jms1005/knock2fa/버튼시퀀스_노크리듬_2FA_계획서.docx

2026 COSS 차세대반도체 MCU 응용 경진대회

출품 계획서 (초안)

버튼 시퀀스 · 노크 리듬 기반 저비용 이중 인증(2FA) 잠금 시스템

※ 본 문서는 대화 내용을 바탕으로 초안을 잡은 것입니다. 대회 요강이 지정하는 정식 항목 번호·양식이 있다면 그에 맞춰 절 번호를 다시 매겨야 합니다 — 원본 공모전 안내문(공모전자료 폴더)과 대조해 주세요.

# 1. 개요

## 1.1 제안 배경

저비용 임베디드 잠금장치는 대부분 버튼 PIN 입력 한 가지에만 의존한다. PIN은 옆에서 지켜보는 것만으로 그대로 노출되는 '지식 기반 단일 인증'이라는 구조적 한계가 있다. 반면 지문·얼굴 인식 등 생체 인증 모듈은 정확하지만 원가와 처리 부담이 커서, 8비트 MCU 한 개·핀 몇 개로 승부하는 이번 대회의 채점 기준(부품 원가, 사용 핀 수, 코드/데이터 메모리 크기)과는 맞지 않는다.

본 프로젝트는 여기서 나노/재료공학 전공자의 관점이 아니라, 저비용 센서 하나를 추가해 '지식'과 '행동'이라는 서로 다른 성격의 증거 두 가지를 요구하는 인증 구조를 저비용·저전력 MCU 위에서 구현하는 데 초점을 둔다.

## 1.2 제안 내용 요약

등록된 버튼 4개를 정해진 순서로 누르는 지식 기반 1단계와, 표면을 두드리는 리듬(간격 패턴)을 압전(피에조) 소자로 측정해 등록된 사용자의 패턴과 비교하는 행동 기반 2단계를 결합한다. 두 단계는 서로 다른 물리 채널(디지털 GPIO / 아날로그 ADC)에서 독립적으로 검증되며, 둘 다 통과해야 잠금이 해제된다.

## 1.3 목표

- 추가 부품 하나(피에조 소자)만으로 지문 인식 수준의 '두 번째 인증 계층'을 저비용으로 구현한다.
- Arduino IDE·외부 라이브러리 없이 ADC·타이머·EEPROM·I²C를 전부 레지스터 직접 제어로 구현한다.
- 동일한 사람이 순서를 알고 있어도 리듬까지 재현하지 못하면 인증에 실패한다는 것을 실측으로 증명한다.

# 2. 문제의식 및 차별점

## 2.1 기존 저비용 잠금장치의 한계

- 버튼 PIN 키패드: 입력 순간을 옆에서 보거나, 자주 누르는 버튼의 마모 흔적만으로도 순서가 유추될 수 있다.
- RFID 카드: 카드 자체를 분실·복제당하면 그대로 무력화된다.
- 지문/얼굴 인식 모듈: 정확하지만 모듈 원가가 최종 시스템 원가를 크게 높이고, 8비트 MCU로는 영상 처리 자체가 어렵다.

## 2.2 본 설계의 접근

정답 '순서'를 안다고 해도, 그 순서를 두드리는 '리듬'까지 똑같이 재현하기는 어렵다는 점에 착안했다. 이는 키보드 타이핑 습관으로 사용자를 구분하는 키스트로크 다이내믹스(keystroke dynamics) 연구와 같은 원리이며, 여기서는 이를 초저가 압전 소자 하나로 구현한다. 두 계층이 서로 다른 센서·회로에서 독립적으로 얻어진다는 점이 핵심이며, 이 덕분에 한쪽 정보가 유출되어도 나머지 한쪽까지 뚫기는 어렵다.

# 3. 동작 원리

## 3.1 인증 구조 — 2단계

- 1단계 (지식): 등록된 버튼 4개 중 정해진 순서로 입력. button.c의 디바운스 로직으로 각 입력을 이벤트화.
- 2단계 (행동): 표면을 두드리는 리듬(노크 간 시간 간격)을 피에조로 측정, 등록된 사용자 패턴과 비교.

두 단계는 순차적으로 진행되며, 1단계를 통과한 경우에만 2단계로 넘어간다. 둘 다 통과해야 최종 '잠금 해제' 신호를 출력한다.

## 3.2 피에조 노크 감지 원리

압전(피에조) 디스크는 기계적 충격을 받으면 압전 효과로 순간적인 전압을 발생시킨다. 이 전압을 저항 분배·클램프 회로를 거쳐 MCU의 ADC 입력으로 샘플링하고, 정해진 임계값을 넘는 순간을 '노크 이벤트'로 판정한다. 두 노크 사이의 시간 간격을 타이머로 측정해 [t1, t2, t3, …] 형태의 시간 벡터를 만든다.

이 방식은 기존 LED PEDD 프로젝트에서 '시간을 재서 벡터로 만들고 분류기에 넣는다'는 접근을 그대로 계승한다. 다만 광량 대신 압전 신호를 트리거로 쓴다는 점이 다르며, 발광-검출 정렬이나 차광 같은 광학적 제약이 전혀 없다는 것이 실무적으로 가장 큰 차이다.

## 3.3 시간 벡터화 및 분류 알고리즘

측정된 간격 벡터는 기존 classify.c의 정수 연산 최근접 중심점(nearest-centroid) 분류기에 그대로 입력된다. 부동소수점을 쓰지 않고 유클리드 거리 제곱의 대소 비교만으로 판정하므로 8비트 MCU에서도 가볍게 동작한다.

## 3.4 학습(등록) 및 인증 흐름

- 학습 모드: 사용자가 같은 순서·리듬을 3~5회 반복 입력 → 평균 벡터(중심점)를 산출해 EEPROM에 저장 (store.c 재사용).
- 인증 모드: 새로 입력된 순서가 일치하는지 먼저 확인 → 일치하면 리듬 벡터와 저장된 중심점 사이의 거리를 계산 → 임계값 이내면 인증 성공, OLED에 결과 표시.

# 4. 시스템 구성

## 4.1 블록도 (텍스트 설명)

버튼 4개 → MCU 디지털 입력(내부 풀업) / 피에조 → 보호저항·전압분배 → MCU 아날로그 입력(ADC) / MCU → OLED(상태 표시) + UART(로그) / 인증 성공 시 MCU → 액추에이터 핀(데모용 LED 또는 서보모터로 '열림' 표시).

## 4.2 MCU 핀 사용 계획

핀 | 연결 대상 | 방향 | 비고
D2 ~ D5 | 버튼 4개 | 입력 (내부 풀업) | 정해진 순서로 입력받는 지식 인증부
A0 (ADC0) | 피에조 소자 | 아날로그 입력 | 노크 충격 전압 샘플링
A4 / A5 | OLED SDA / SCL | I²C | 기존 i2c.c · ssd1306.c 재사용
D8 | 액추에이터 / 상태 LED | 출력 | 인증 성공 시 '열림' 신호
— (USB) | UART 로그 | 직렬 | 보드의 USB 단자가 담당

총 사용 핀 7~8개 수준으로, 대회 채점 기준(사용 핀 수)에서 여유가 있다.

## 4.3 소프트웨어 구성 — 재사용 모듈

모듈 | 기존 LED 프로젝트에서의 역할 | 이번 프로젝트에서의 역할
button.c | Phase 4 버튼 디바운스 | 버튼 시퀀스 입력 이벤트화 (그대로 재사용)
classify.c | R/G/B 방전시간 벡터 최근접 중심점 분류 | 노크 간격 벡터 최근접 중심점 분류 (그대로 재사용)
store.c | EEPROM에 학습된 중심점 저장 | 사용자별 등록 패턴 저장 (그대로 재사용)
i2c.c / ssd1306.c | OLED에 판정 결과 출력 | 인증 상태·안내 문구 출력 (그대로 재사용)
uart.c | 측정값 CSV 로깅 | 인증 시도 로그, 실험 데이터 수집 (그대로 재사용)
pedd.c 아키텍처 | Analog Comparator + Timer1 캡처로 방전시간 측정 | 신규 adc_knock.c로 대체 — ADC + 타이머로 노크 간격 측정

# 5. 대회 제약사항 준수

- MCU: ATmega328P (16MHz), Arduino Uno 호환보드 사용 — 요강상 사용 가능 MCU.
- Arduino IDE 및 외부 라이브러리 미사용 — 개발 환경은 Microchip Studio, 전 구간 레지스터 직접 제어.
- 부동소수점 미사용 — 전 구간 32비트 정수 연산 (classify.c 기존 구현 그대로 계승).

# 6. 부품 목록 및 원가

## 6.1 기존 보유 부품 (그대로 재사용)

품목 | 사양 | 수량 | 비고
Arduino Uno 호환보드 | ATmega328P 탑재 | 2 (본체+예비) | LED 프로젝트에서 이미 확보
택트 스위치 | 4핀 | 5 | 시퀀스 입력용
I²C OLED | 0.96" SSD1306 | 1 | 상태 표시
저항 | 220 / 330 / 470 / 1kΩ | 각 10 | 회로 보조용
브레드보드 · 점퍼선 | 830핀 + M/M, M/F | 1식

## 6.2 신규 구매 필요

품목 | 사양 | 수량 | 예상 단가 | 비고
피에조 진동/노크 센서 | 압전 디스크 | 2 | 약 500~1,500원 | 노크 리듬 측정 핵심 부품
저항 | 1MΩ | 2 | 약 100원 | ADC 핀 보호용 블리드 저항

신규 구매 총액은 약 2,000~3,500원 수준으로, LED 프로젝트 대비 부품 리스크와 배송 대기 부담이 크게 줄어든다.

# 7. 실험 및 검증 계획

단계 | 목적 | 방법 | 판정 기준
① 피에조 특성 측정 | 노크 세기별 ADC 응답 확인 | 약하게/세게 두드리며 ADC 값 기록 | 노크 유무를 구분하는 임계값 결정
② 버튼 시퀀스 단독 검증 | 1단계 동작 확인 | 정답/오답 순서 각각 입력 | 정답만 통과, 오답은 전부 거부
③ 리듬 재현성 측정 | 동일 사용자 반복 시 변동성 확인 | 같은 사용자가 10회 이상 반복 입력 | 변동계수(CV)가 임계값 설계 범위 이내
④ 타인 모사 시도 | 2FA 효과 실증 (핵심 실험) | 순서를 알려준 제3자가 흉내내어 시도 | 순서를 알아도 리듬 불일치로 거부되는 비율 측정
⑤ 실패 대응 확인 | 오인식 시 동작 확인 | 임계값 경계 부근에서 반복 시도 | 재시도 제한, 안내 문구 정상 표시

# 8. 개발 일정 (9/9 ~ 9/18)

기간 | 작업
9/9 ~ 9/10 | 계획서 확정, 피에조·저항 주문, 회로도·핀 배정 확정
9/10 ~ 9/12 | 부품 도착, adc_knock.c 작성 및 버튼·피에조 단독 동작 검증
9/12 ~ 9/14 | classify.c·store.c 연동, 학습/인증 흐름 통합 및 1차 테스트
9/14 ~ 9/16 | 실험 ①~⑤ 진행, 데이터 수집 및 임계값 튜닝
9/16 ~ 9/18 | 계획서·회로도·발표자료(PPT) 최종화, 시연 영상 촬영, 제출

# 9. 기대효과 및 차별성

- 추가 원가 약 2,000~3,500원 수준으로 지식+행동 이중 인증을 구현 — 지문 모듈 대비 압도적으로 저렴.
- Arduino 라이브러리 없이 ADC·타이머·EEPROM·I²C를 전부 레지스터로 직접 구현 — 대회가 요구하는 순수 구현력에 부합.
- 기존 LED PEDD 프로젝트에서 검증된 '시간 벡터 → 정수 분류기' 아키텍처를 재사용해 개발 리스크와 일정 리스크를 최소화.
- 타인 모사 시도 실험으로 2FA 효과를 정량적으로 증명 — 단순 아이디어 제시에 그치지 않고 실측 데이터로 뒷받침.

# 10. 한계점 및 향후 계획

- 피에조 신호는 부착 방식·표면 재질에 따라 민감도가 달라질 수 있다 — 향후 다중 피에조 또는 디지털 필터링으로 개선 가능.
- 리듬 재현성은 개인 컨디션에 따라 변동할 수 있다 — 등록 시 다회 샘플링과 임계값 여유 설계로 대응.
- 현재 EEPROM 용량 한계상 등록 가능한 사용자 수가 제한적이다 — 다중 사용자 지원은 향후 과제로 남긴다.

# 11. 참고

본 계획서는 2026 COSS 차세대반도체 MCU 응용 경진대회 출품을 위해 기존 'LED 다파장 재이용 광검출 기반 저비용 액체 광학 분석기' 프로젝트에서 확보한 소프트웨어 아키텍처(정수 연산 분류기, EEPROM 저장, OLED·UART 출력)를 재사용하여 작성되었다.
