jms1005/knock2fa/최종 보고서.pdf

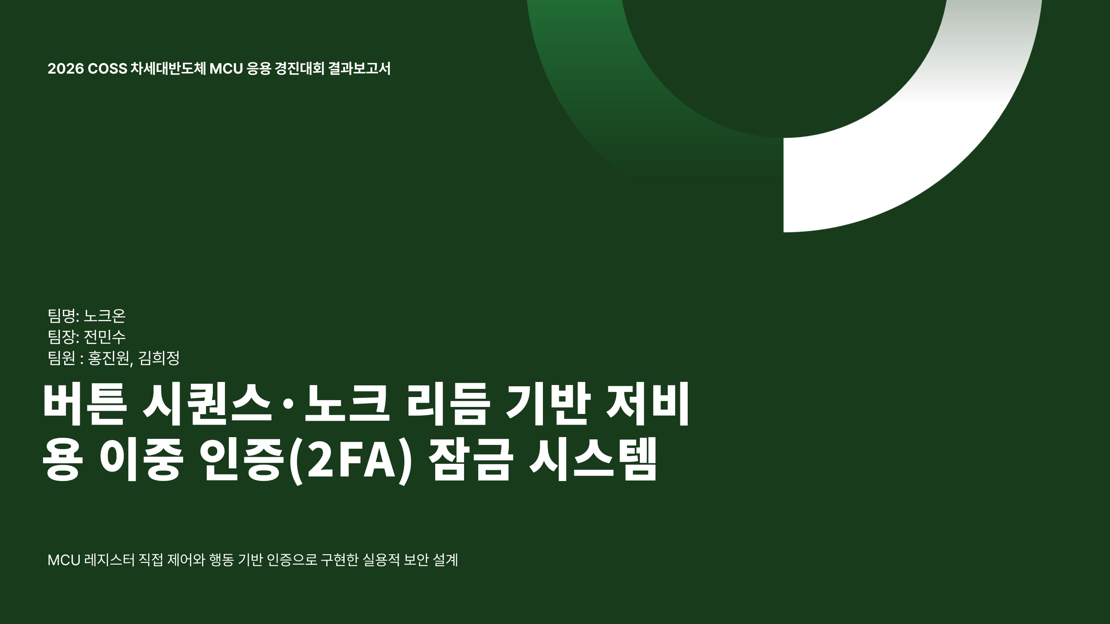
[picture p1: page 1]

MCU 레레레레 | 레레 레레레 | 레레 레레 레레레레 | 레레레 | 레레레 | 레레 레레
레레 레레레 | · 레레 레레 레레 레레

# 레 레레 레레 (2FA) 레레 레레레

2026 COSS | 레레레레레레 | MCU 레레 레레레레 | 레레레레레

레레 : 레레레
레레 : 레레레
레레 : 레레레 , 레레레

레레 레레레 | 레레레레레 | 레레

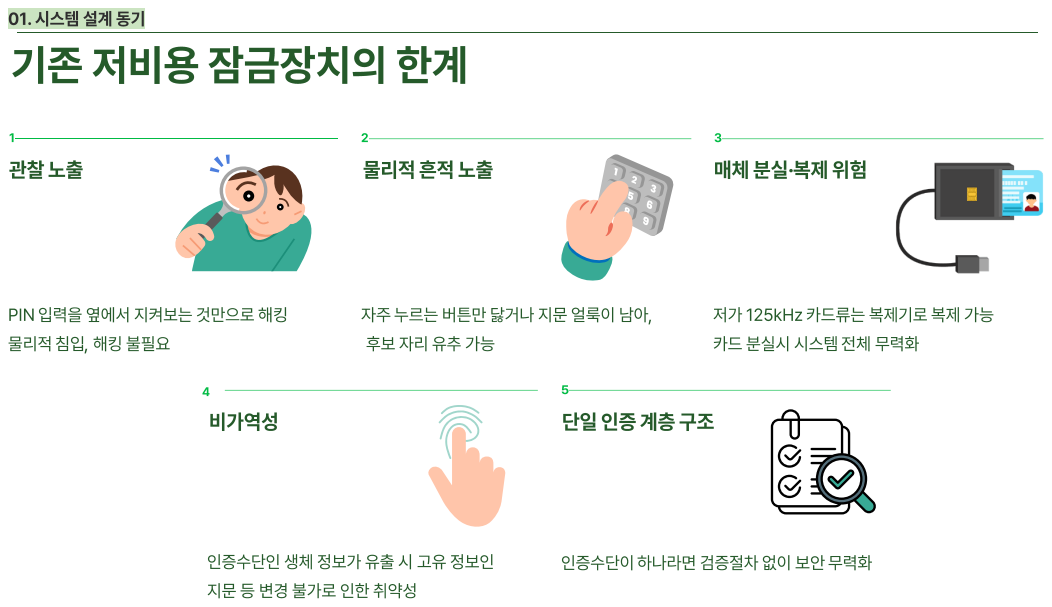
[picture p2: page 2]
PIN 레레레; 레레레; 레레레레; 레레 , 레레 레레레; 레레 레레레; 레레 125kHz 레레레레; 레레레레레; 레레 레 레레 레레레; 레레 레레 레레레

Keystroke Dynamics | 레레 레레레 | 레레 레레 레레

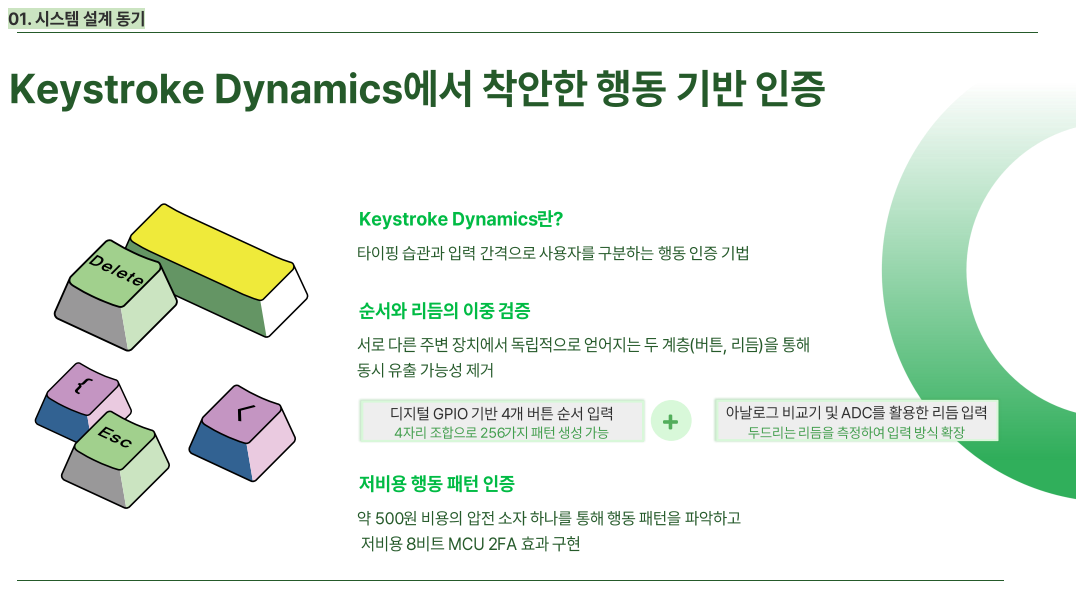
[picture p3: page 3]
레레레; 레레 레레레레; 레레레레; Keystroke Dynamics; 레레 레레 레레 레레레레; 레레레레레; 레레 레레 레레레; 레 500 레 레레레; 8레레 MCU 2FA 레레 레레; 레 ADC 레 레레레; GPIO 레레 4레 레레 레레 레레; 4레레 레레레레

# 레레레레

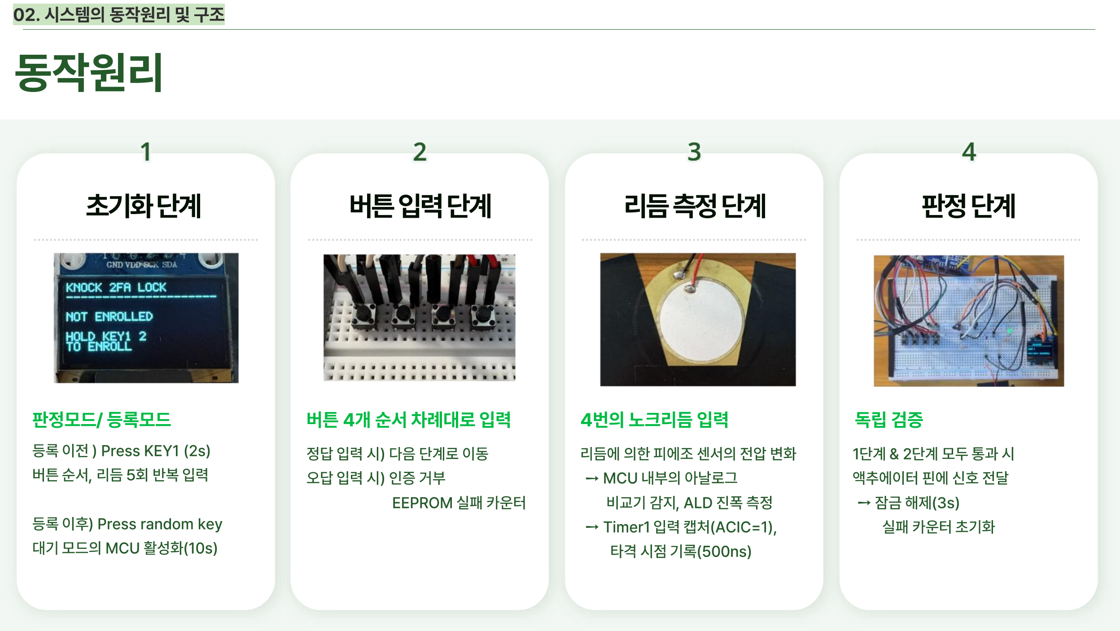
[picture p4: page 4]

레레 레레 ) Press KEY1 (2s)
레레 레레 , 레레 5레 레레 레레

레레 레레 ) Press random key
레레 레레레 | MCU 레레레 (10s)
레레레레 | / 레레레레
레레 레레 레 ) 레레 레레레 | 레레
레레 레레 레 ) 레레 레레
EEPROM 레레 레레레
레레 4 레 레레 레레레레 | 레레
레레레 | 레레 레레레 | 레레레 | 레레 레레
➙ MCU 레레레 | 레레레레
레레레 | 레레 , ALD 레레 레레
➙ Timer1 레레 레레 (ACIC=1),
레레 레레 레레 (500ns)

### 4 레레 레레레레 레레

1레레 & 2레레 레레 레레 레
레레레레레 레레 레레 레레
➙ 레레 레레 (3s)
레레 레레레 레레레

### 레레 레레

레레레 레레 | 레레 레레 레레 | 레레 레레 레레 | 레레 레레
02. | 레레레레 | 레레레레 | 레 | 레레

# 레레 레레레레 - 2레레 & 3레레

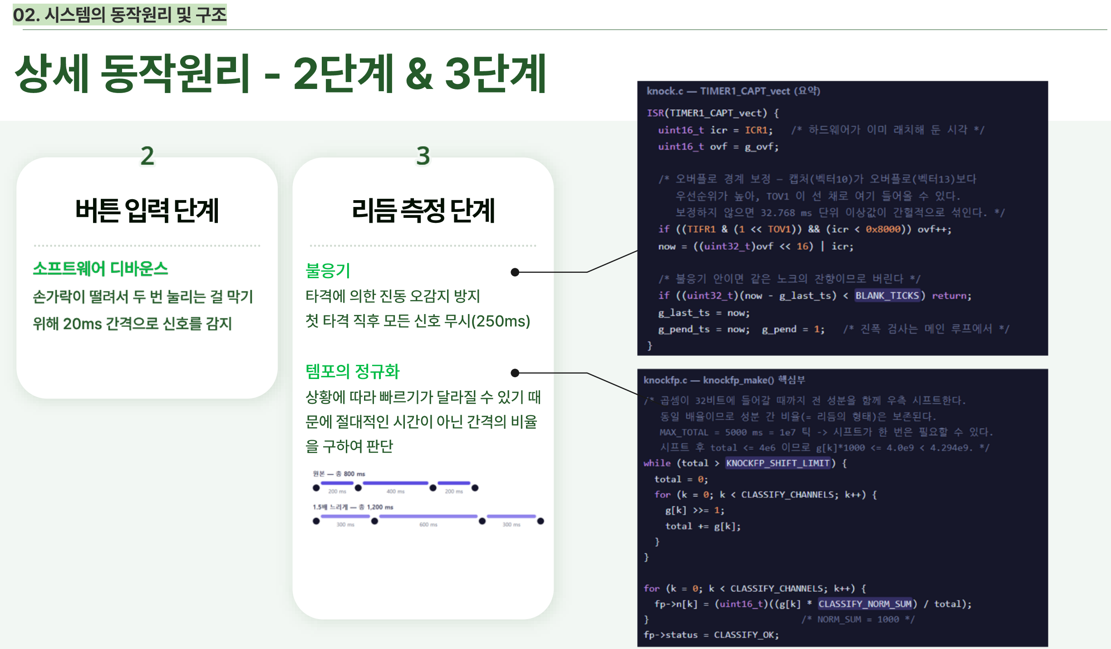
[picture p5: page 5]

불불불
레레레 | 레레 레레 레레레 | 레레
레 레레 레레 레레 레레 레레 (250ms)
불불불 | 불불불
레레레 | 레레 레레레레 | 레레레 | 레 레레 레
레레 레레레레 | 레레레 | 레레 레레레 | 레레
레 레레레 | 레레
레레 레레 레레 | 레레 레레 레레
02. | 레레레레 | 레레레레 | 레 | 레레

# 레레 레레레레 - 4 레레

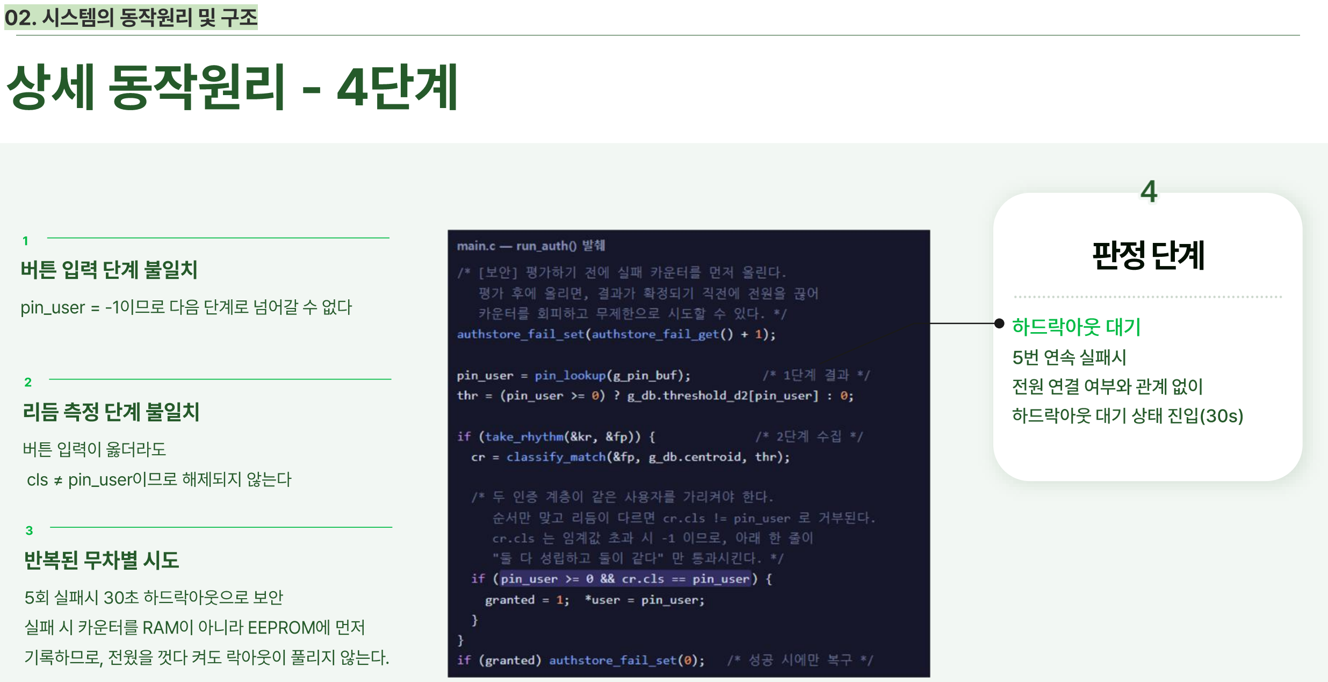
[picture p6: page 6]

불불불불불 불불
5레 레레 레레레
레레 레레 레레레 | 레레 레레
레레레레레 | 레레 레레 레레 (30s)

# 레레 레레

pin_user = - 1레레레 | 레레 레레레 | 레레레 | 레 레레

1
레레 레레 레레 레레레
레레 레레레 | 레레레레
cls ≠ pin_user 레레레 | 레레레레 | 레레레

2
레레 레레 레레 레레레
5레 레레레 | 30 레 레레레레레레레 | 레레
레레 레 레레레레 | RAM레 레레레 | EEPROM 레 레레
레레레레레 | , 레레레 | 레레 레레 레레레레 | 레레레 | 레레레 .

3
레레레 | 레레레 | 레레
02. | 레레레레 | 레레레레 | 레 | 레레

# 레레레 레레레

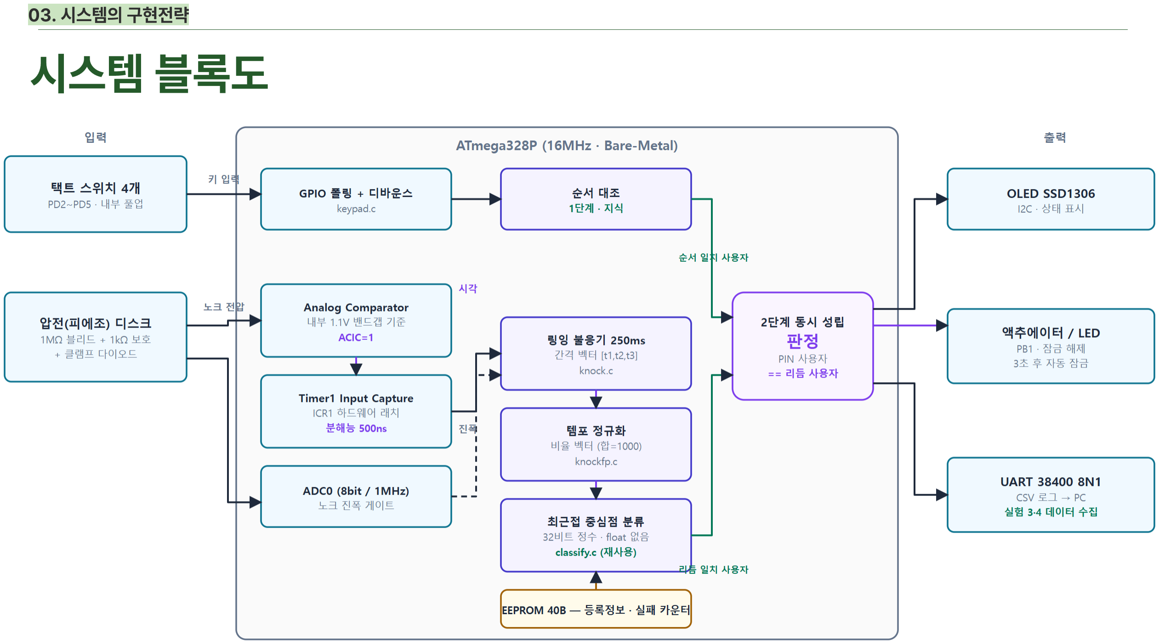
[picture p7: page 7]

03. | 레레레레 | 레레레레

# 레레레레 레레

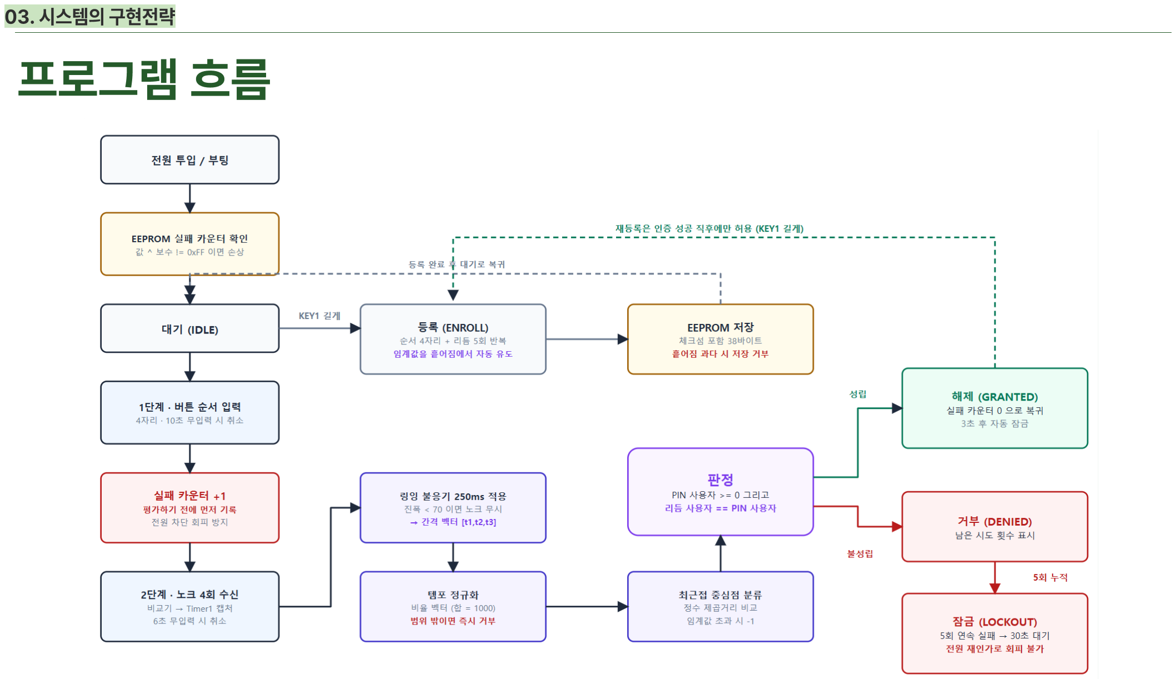
[picture p8: page 8]

03. | 레레레레 | 레레레레

# 레레 레레

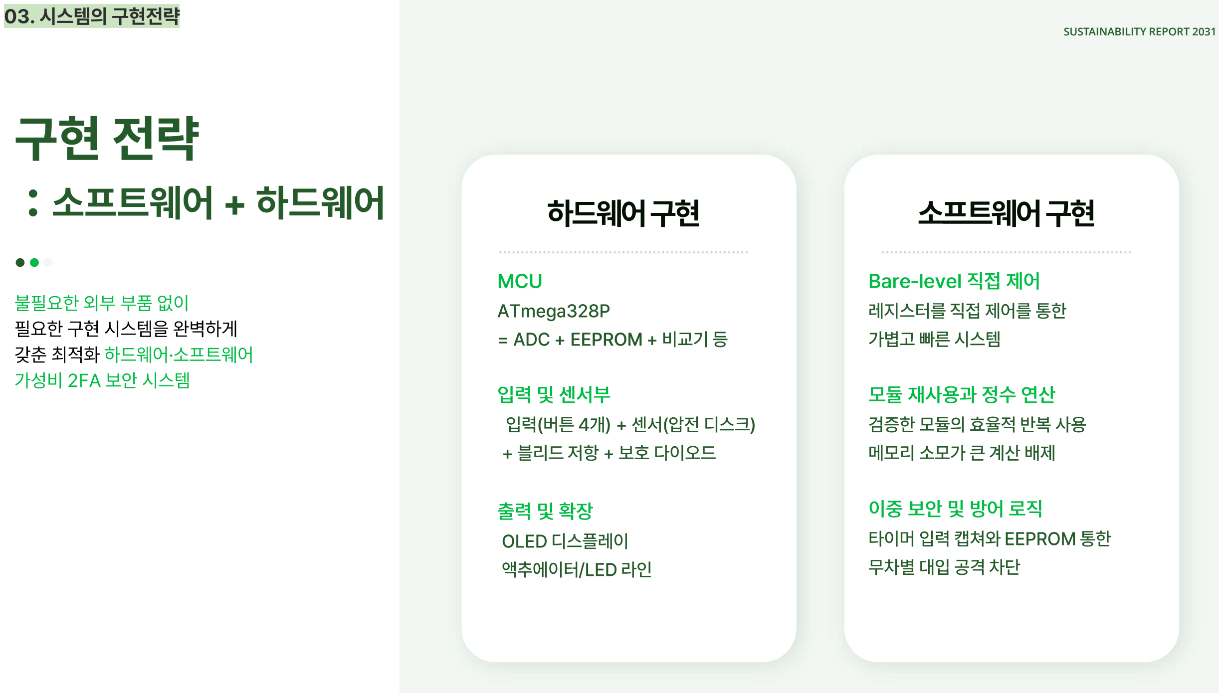
[picture p9: page 9]

# : 레레레레레 + 레레레레

SUSTAINABILITY REPORT 2031

03. | 레레레레 | 레레레레

MCU
ATmega328P
= ADC + EEPROM + 레레레 레

불불 불 불불불
레레 (레레 4 레 ) + 레레 (레레 레레레 ) + 레레레 레레 + 레레 레레레레

불불 불 불불
OLED 레레레레레
레레레레레 | /LED 레레
레레레레 | 레레 | 레레레레레 | 레레

Bare -level 불불 불불
레레레레레 | | 레레 레레레 | 레레
레레레 | 레레 레레레
불불 불불불불 | 불불 불불
레레레 | 레레레 | 레레레 | 레레 레레
레레레 | 레레레 | 레 레레 레레

불불 불불 불 불불 불불
레레레 | 레레 레레레 | EEPROM 레레
레레레 | 레레 레레 레레
레레레레 | 레레 레레 레레
레레레 | 레레 레레레레 | 레레레레
레레 레레레 | 레레레레 | ·레레레레레
레레레 | 2FA 레레 레레레

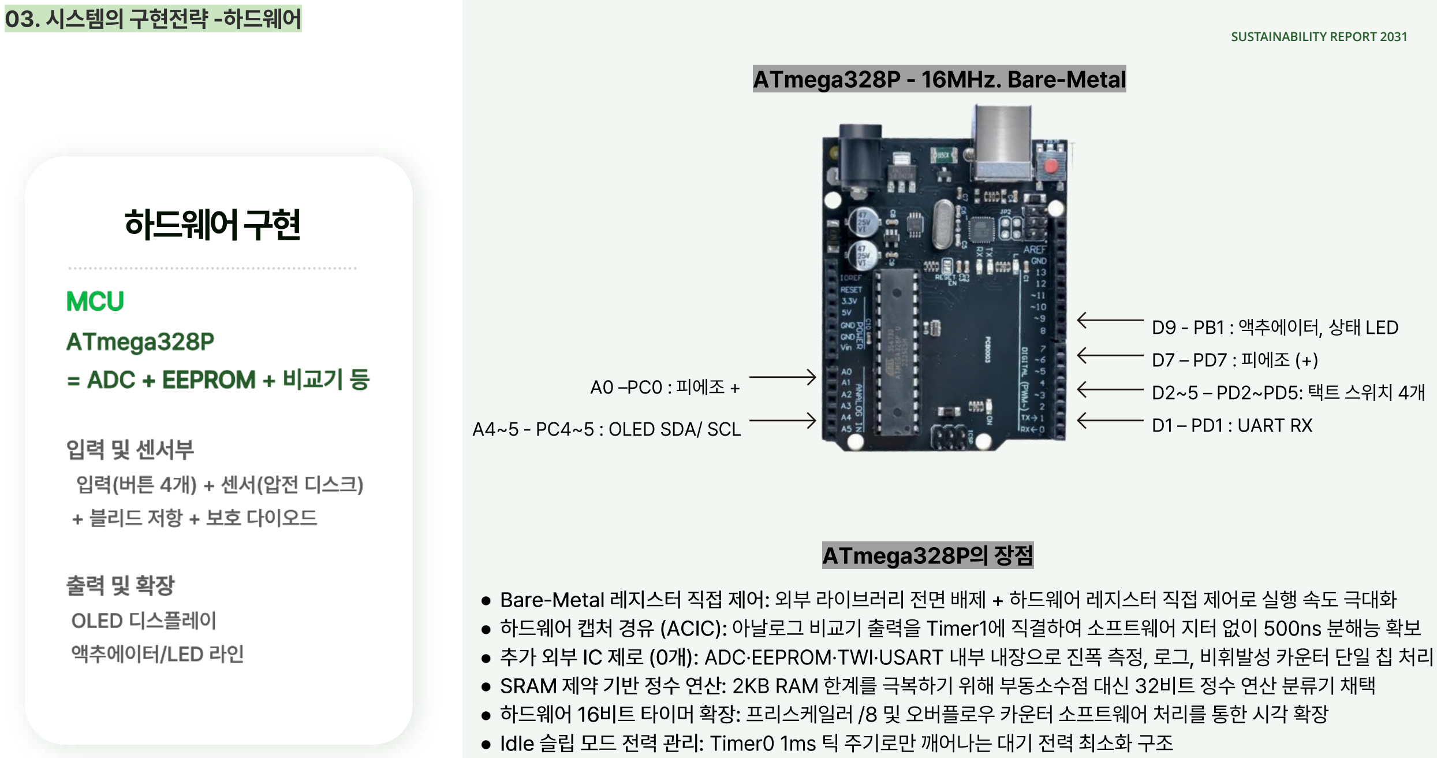
[picture p10: page 10]

SUSTAINABILITY REPORT 2031

03. | 레레레레 | 레레레레 | - 레레레레
레레레레 | 레레
ATmega328P | - | 16MHz. Bare | -Metal
D9 - PB1 : 레레레레레 | , 레레 LED
D7 – PD7 : 레레레 | (+)
D2~5 – PD2~PD5: 레레 레레레 | 4레

D1 – PD1 : UART RX

A0 –PC0 : 레레레 +

A4~5 - PC4~5 : OLED SDA/ SCL

- Bare -Metal 불불불불 | 불불 불불 : 레레 레레레레레 | 레레 레레 + 레레레레 | 레레레레 | 레레 레레레 | 레레 레레 레레레
- 불불불불 | 불불 불불 (ACIC): 레레레레 | 레레레 | 레레레 | Timer1레 레레레레 | 레레레레레 | 레레 레레 500ns 레레레 | 레레
- 불불 불불 IC 불불 (0 불 ): ADC·EEPROM·TWI·USART | 레레 레레레레 | 레레 레레 , 레레 , 레레레레 | 레레레 | 레레 레 레레
- SRAM 불불 불불 불불 불불 : 2KB RAM 레레레 | 레레레레 | 레레 레레레레레 | 레레 32 레레 레레 레레 레레레 | 레레
- 불불불불 | 16불불 불불불 | 불불 : 레레레레레레 | /8 레 레레레레레 | 레레레 | 레레레레레 | 레레레 | 레레 레레 레레
- Idle 불불 불불 불불 불불 : Timer0 1ms 레 레레레레 | 레레레레 | 레레 레레 레레레 | 레레
ATmega328P | 레 | 레레

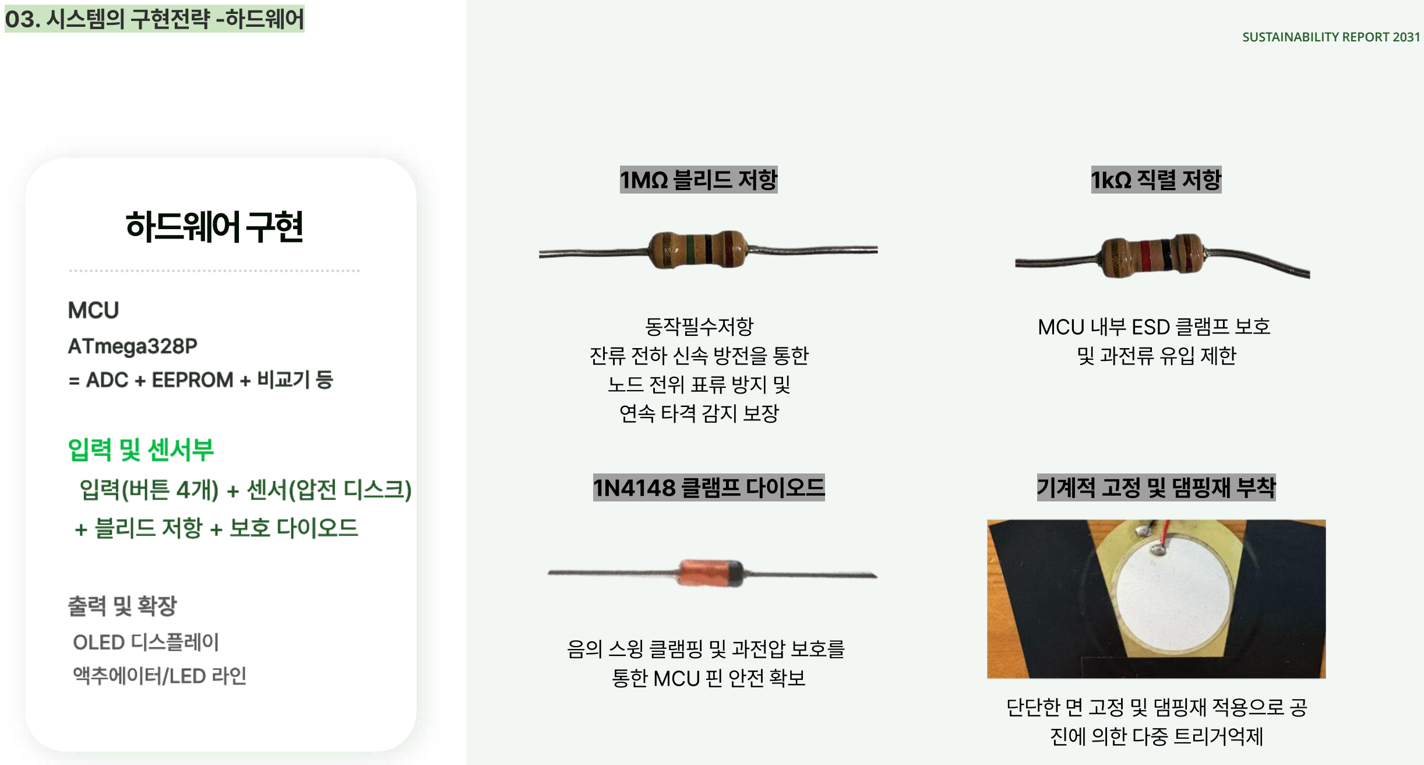
[picture p11: page 11]

SUSTAINABILITY REPORT 2031

03. | 레레레레 | 레레레레 | - 레레레레
레레레레 | 레레
1MΩ | 레레레 | 레레

레레레레레레
레레 레레 레레 레레레 레레
레레 레레 레레 레레 레
레레 레레 레레 레레
1kΩ | 레레 | 레레
MCU 레레 ESD 레레레 | 레레
레 레레레 | 레레 레레
1N4148 | 레레레 | 레레레레
레레 레레 레레레 | 레 레레레 | 레레레
레레 MCU 레 레레 레레
레레레 | 레레 | 레 | 레레레 | 레레
레레레 | 레 레레 레 레레레 | 레레레레 | 레
레레 레레 레레 레레레레레

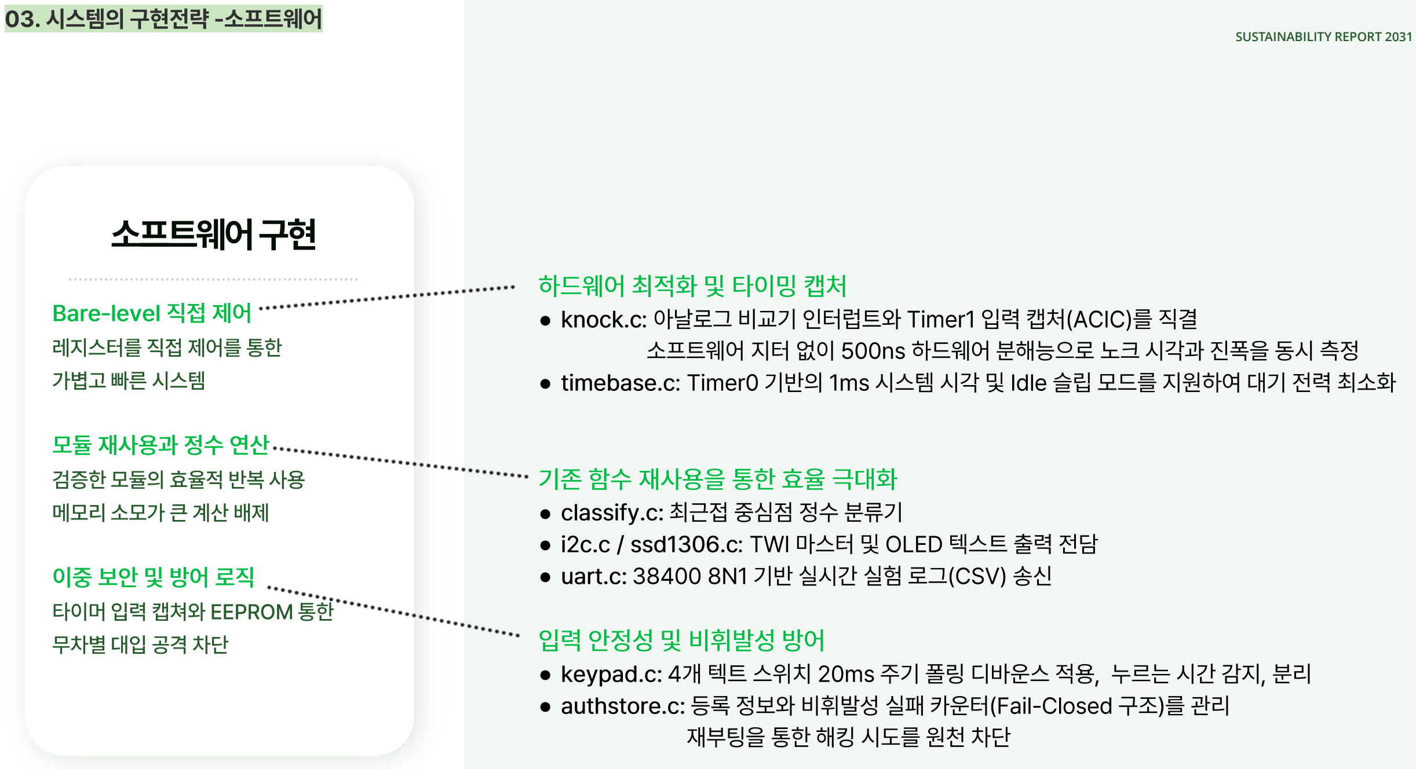
[picture p12: page 12]

SUSTAINABILITY REPORT 2031

03. | 레레레레 | 레레레레 | - 레레레레레
레레레레레 | 레레

Bare -level 불불 불불
레레레레레 | | 레레 레레레 | 레레
레레레 | 레레 레레레
불불 불불불불 | 불불 불불
레레레 | 레레레 | 레레레 | 레레 레레
레레레 | 레레레 | 레 레레 레레

불불 불불 불 불불 불불
레레레 | 레레 레레레 | EEPROM 레레
레레레 | 레레 레레 레레
불불불불 | 불불불 | 불 불불불 | 불불
- knock.c : 레레레레 | 레레레 | 레레레레레 | Timer1 레레 레레 (ACIC) 레 레레
레레레레레 | 레레 레레 500ns 레레레레 | 레레레레레 | 레레 레레레 | 레레레 | 레레 레레
- timebase.c : Timer0 레레레 | 1ms 레레레 | 레레 레 Idle 레레 레레레 | 레레레레 | 레레 레레 레레레
불불 불불 불불불불 | 불불 불불 불불불
- classify.c: 레레레 | 레레레 | 레레 레레레
- i2c.c / ssd1306.c : TWI 레레레 | 레 OLED 레레레 | 레레 레레
- uart.c: 38400 8N1 레레 레레레 | 레레 레레 (CSV) 레레
불불 불불불 | 불 불불불불 | 불불
- keypad.c: 4레 레레 레레레 | 20ms 레레 레레 레레레레 | 레레 , 레레레 | 레레 레레 , 레레
- authstore.c: 레레 레레레 | 레레레레 | 레레 레레레 (Fail -Closed 레레 )레 레레
레레레레 | 레레 레레 레레레 | 레레 레레

# 6 레레 레레레

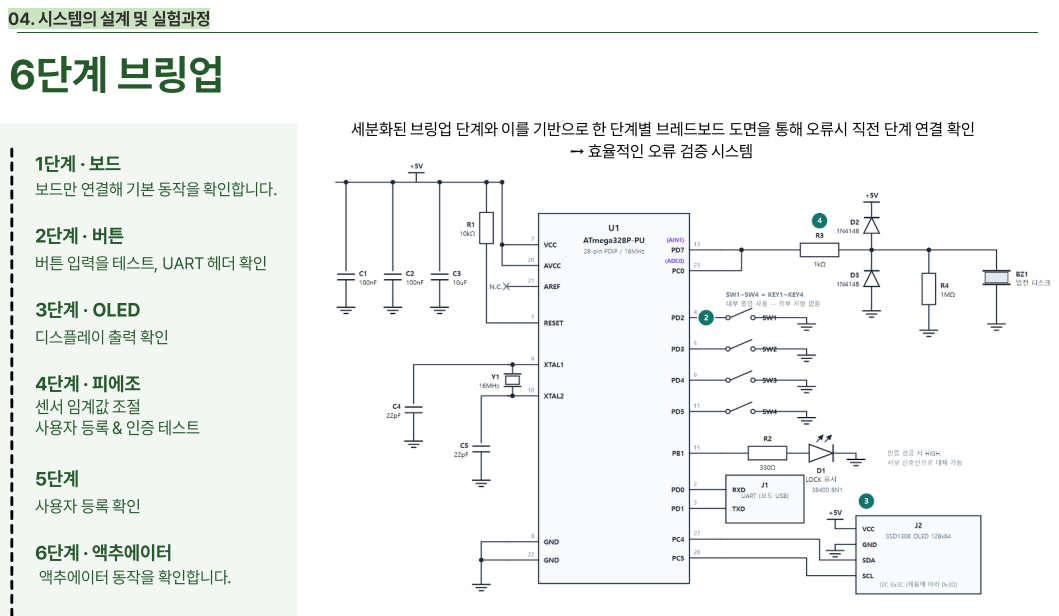
[picture p13: page 13]
레레레레; 레레레; 레레 레레레; 레레레레레; 3 레레 · OLED; 레레 & 레레 레레레; 4 레레 · 레레레; 레레레 , UART 레레 레레; 6 레레 · 레레레레레; 레레 레레레레; 레 레레레; ➙ 레레레레; 레레 레레 레레레

# 6 레레 레레레 - 1레레

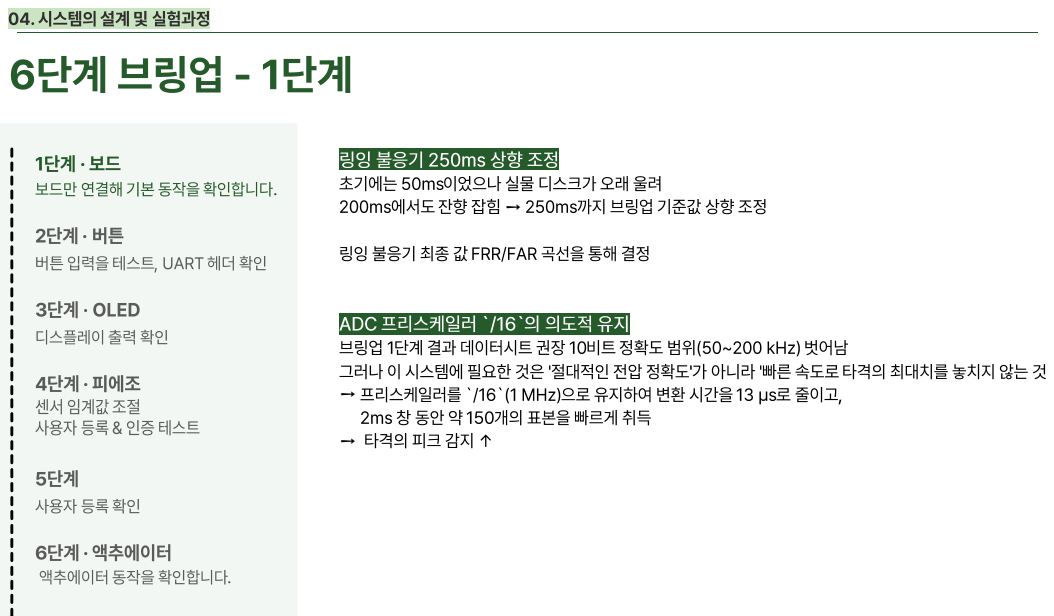
[picture p14: page 14]
레레레레; 레레레; 레레 레레레; 레레레레레; 3 레레 · OLED; 레레 & 레레 레레레; 4 레레 · 레레레; 레레레 , UART 레레 레레; 6 레레 · 레레레레레; 불불불; 50ms 레레레레; 레레 레레레레; 200ms 레레레; 레레 레레 ➙ 250ms 레레 레레레; 레레 레 FRR/FAR 레레레; ADC; 불불불불불불; 1레레 레레 레레레레레; 레레 10레레 레레레; 레레 (50~200 kHz) 레레레; 레 레레레레; 레레 '레레레레; 레레 레레레 '레 레레레; '레레 레레레; ➙ 레레레레레레레; `/16`(1 MHz) 레레 레레레레; 13 µs 레 레레레 ,; 2ms 레 레레 레 150레레 레레레; ➙ 레레레

# 6 레레 레레레 - 2레레

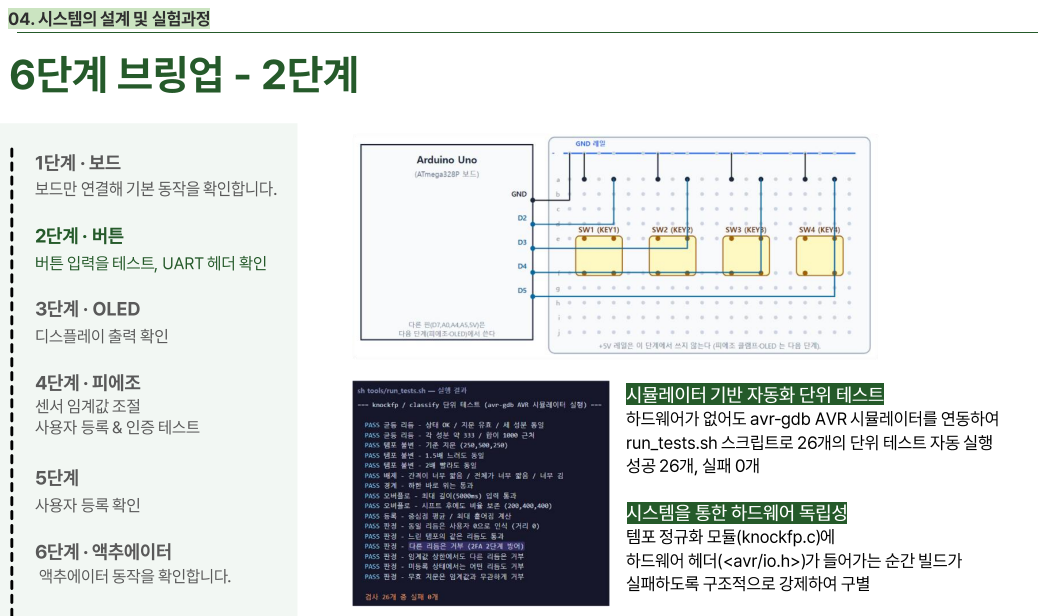
[picture p15: page 15]
레레레레; 레레레; 레레 레레레; 레레레레레; 3 레레 · OLED; 레레 & 레레 레레레; 4 레레 · 레레레; 레레레 , UART 레레 레레; 6 레레 · 레레레레레; 불불불불불; 불불불; avr- gdb AVR 레레레레레레; run_tests.sh 레레레레레; 26 레레 레레 레레레; 불불불불; 레레 (knockfp.c) 레; 레레 (<avr/io.h>) 레 레레레레

6 레레 레레레 | - 3 레레 (레레레 | 레레 )

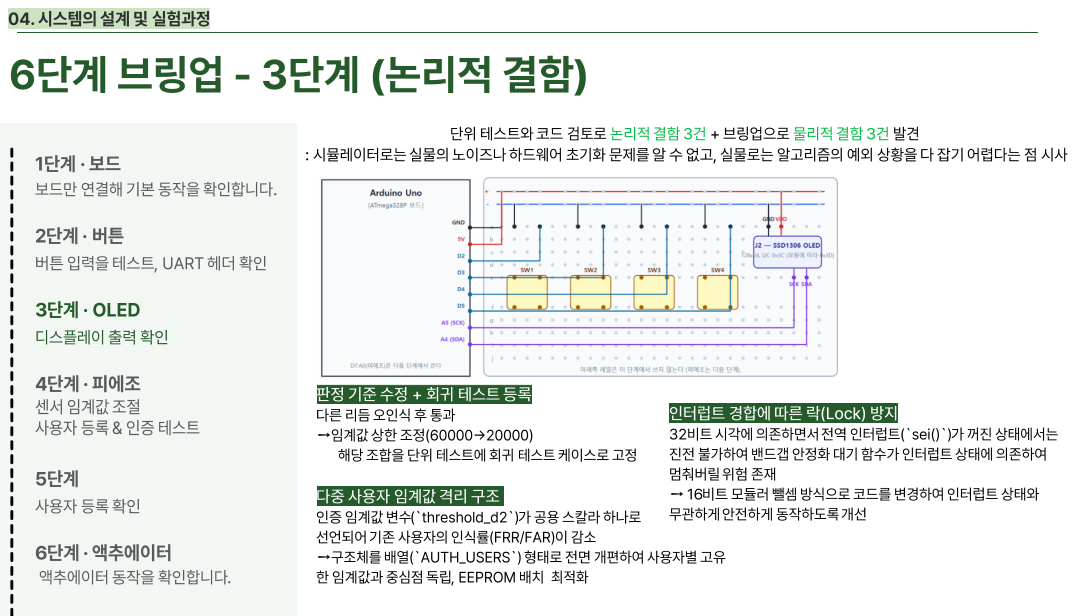
[picture p16: page 16]
레레레레; 레레레; 레레 레레레; 레레레레레; 3 레레 · OLED; 레레 & 레레 레레레; 4 레레 · 레레레; 레레레 , UART 레레 레레; 6 레레 · 레레레레레; 불불불; 레레 레레 레레레; ➙레레레; 레레 레레레레; 레레 (`threshold_d2`) 레 레레 레레레; 레레레 (FRR/FAR) 레 레레; ➙레레레레; 레레 (`AUTH_USERS`); 레 레레레레; 레레 , EEPROM 레레; 레레 3레 + 레레레레레; : 레레레레레레레; 레 레 레레 , 레레레레; 레 레레 레레레레; 불불불불; (Lock); 32 레레 레레레; (`sei()`) 레 레레 레레레레레; ➙ 16레레 레레레

6 레레 레레레 | - 3 레레 (레레레 | 레레 )

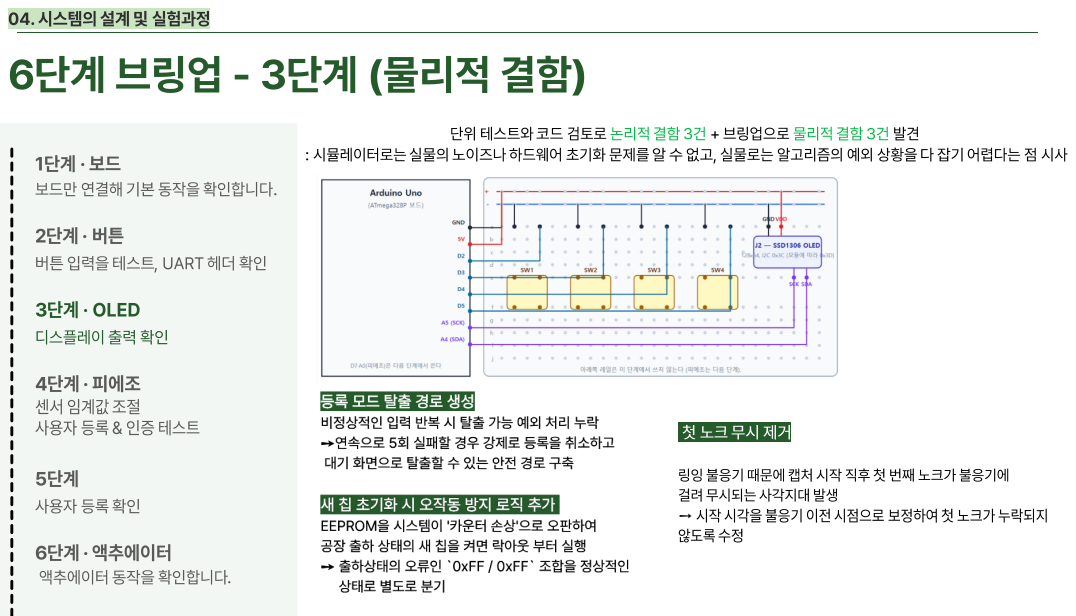
[picture p17: page 17]
레레레레; 레레레; 레레 레레레; 레레레레레; 3 레레 · OLED; 레레 & 레레 레레레; 4 레레 · 레레레; 레레레 , UART 레레 레레; 6 레레 · 레레레레레; 레레 레레레레; 레레 3레 + 레레레레레; : 레레레레레레레; 레 레 레레 , 레레레레; 레 레레 레레레레; 레레 레레 레레 레 레레 레레레; ➙ 레레 레레레; 레 레레레

# 6 레레 레레레 - 4&6 레레

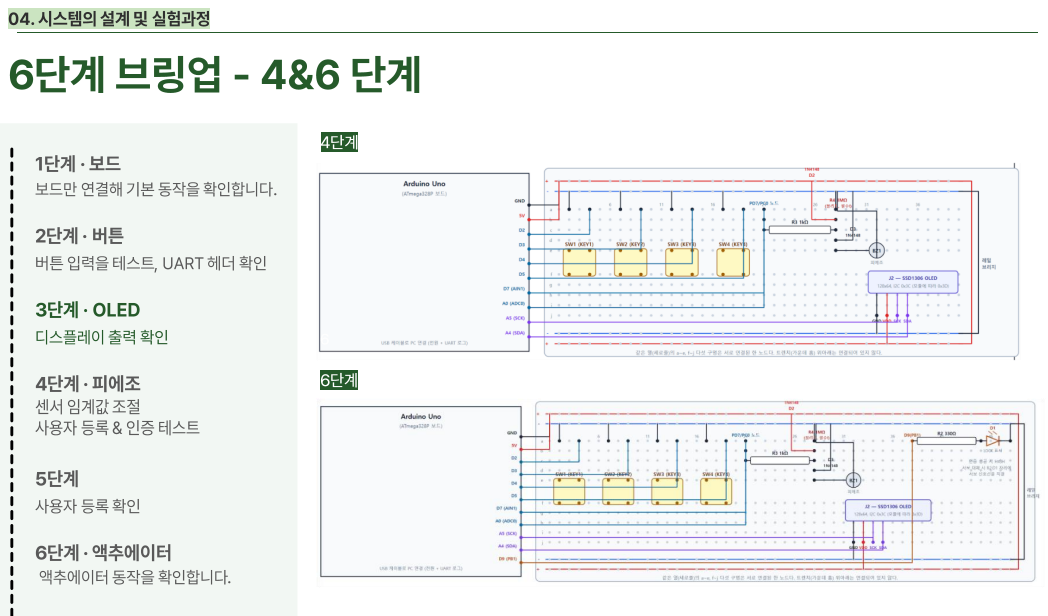
[picture p18: page 18]
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

# 레레 레레 - 1. 레레레 레레레

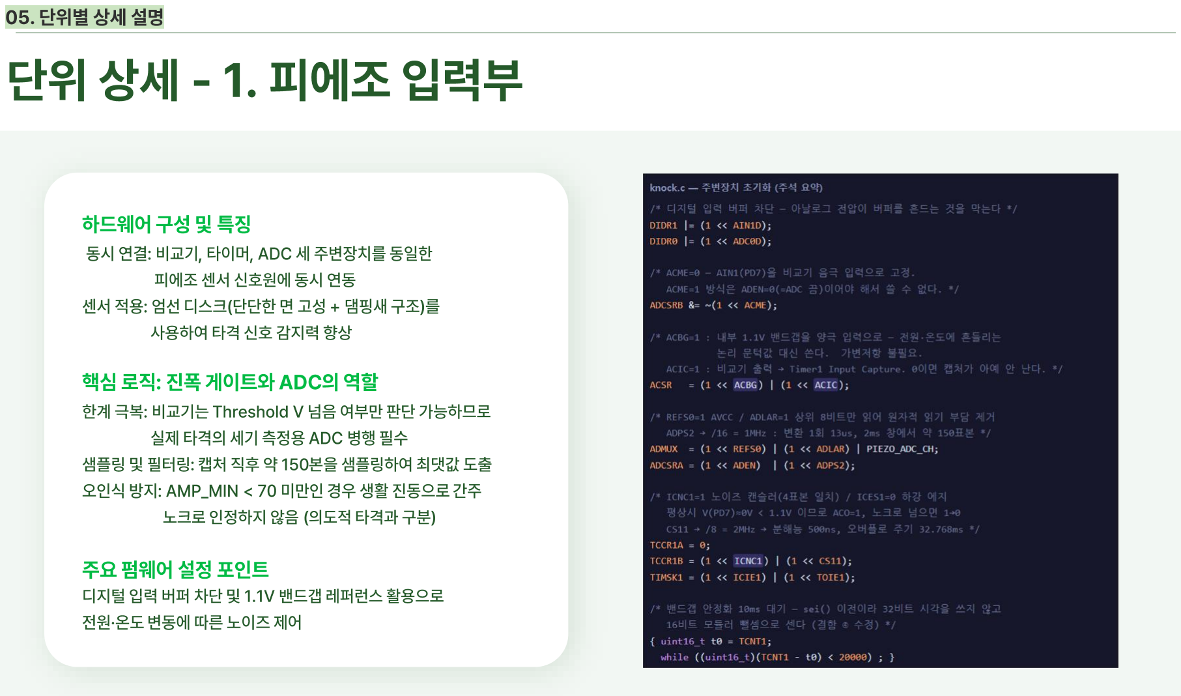
[picture p19: page 19]

레레 레레 : 레레레 , 레레레 , ADC 레 레레레레레 | 레레레
레레레 | 레레 레레레레 | 레레 레레
레레 레레 : 레레 레레레 (레레레 | 레 레레 + 레레레 | 레레 )레
레레레레 | 레레 레레 레레레 | 레레
레레 레레 : 레레레레 | Threshold V 레레 레레레 | 레레 레레레레레
레레 레레레 | 레레 레레레 | ADC 레레 레레
레레레 | 레 레레레 : 레레 레레 레 150 레레 레레레레레 | 레레레 | 레레
레레레 | 레레 : AMP_MIN < 70 레레레 | 레레 레레 레레레레 | 레레
레레레 | 레레레레 | 레레 (레레레 | 레레레 | 레레 )
레레레 | 레레 레레 레레 레 1.1V 레레레 | 레레레레 | 레레레레
레레 ·레레 레레레 | 레레 레레레 | 레레
레레레레 | 레레 레 레레
05. | 레레레 | 레레 | 레레
레레 레레 : 레레 레레레레 | ADC 레 레레
레레 레레레 | 레레 레레레

# 레레 레레 - 2. 레레 레레레

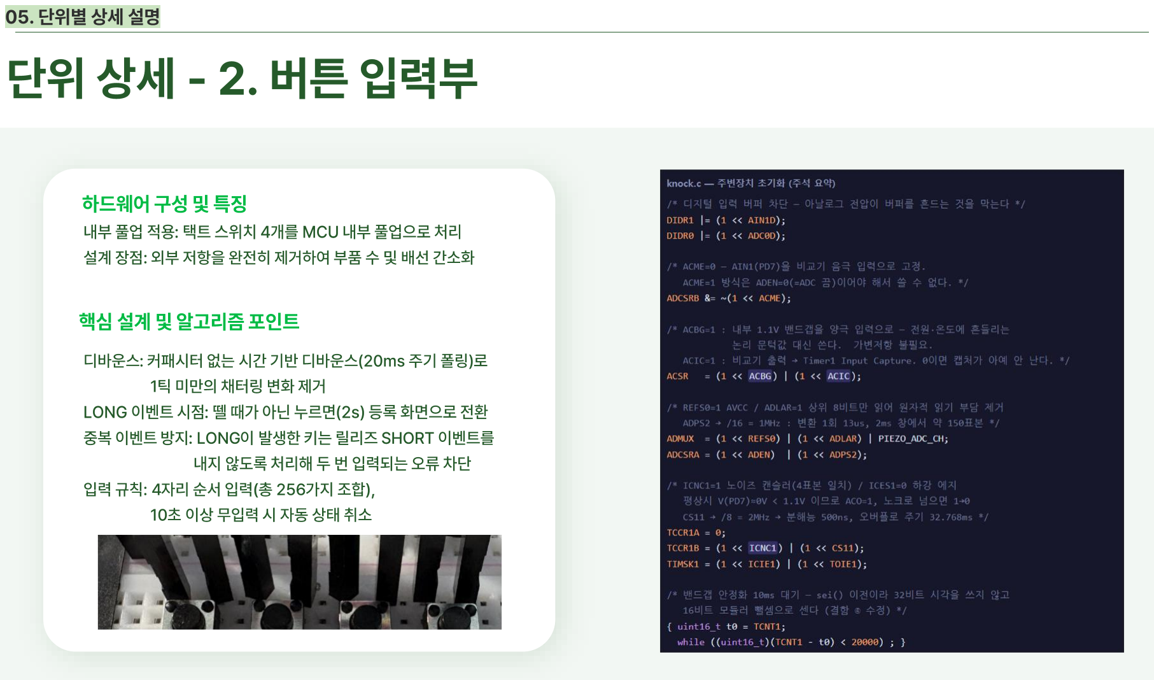
[picture p20: page 20]

레레 레레 레레 : 레레 레레레 | 4레레 MCU 레레 레레레레 | 레레
레레 레레 : 레레 레레레 | 레레레 | 레레레레 | 레레 레 레 레레 레레레
레레레레 | : 레레레레 | 레레 레레 레레 레레레레 | (20ms 레레 레레 )레
1레 레레레 | 레레레 | 레레 레레
LONG 레레레 | 레레 : 레 레레 레레 레레레 (2s) 레레 레레레레 | 레레
레레 레레레 | 레레 : LONG 레 레레레 | 레레 레레레 | SHORT 레레레레
레레 레레레 | 레레레 | 레 레 레레레레 | 레레 레레
레레 레레 : 4 레레 레레 레레 (레 256 레레 레레 ),
10레 레레 레레레 | 레 레레 레레 레레
레레레레 | 레레 레 레레
레레 레레 레 레레레레 | 레레레
05. | 레레레 | 레레 | 레레

# 레레 레레 - 3. OLED/ UART 레레레

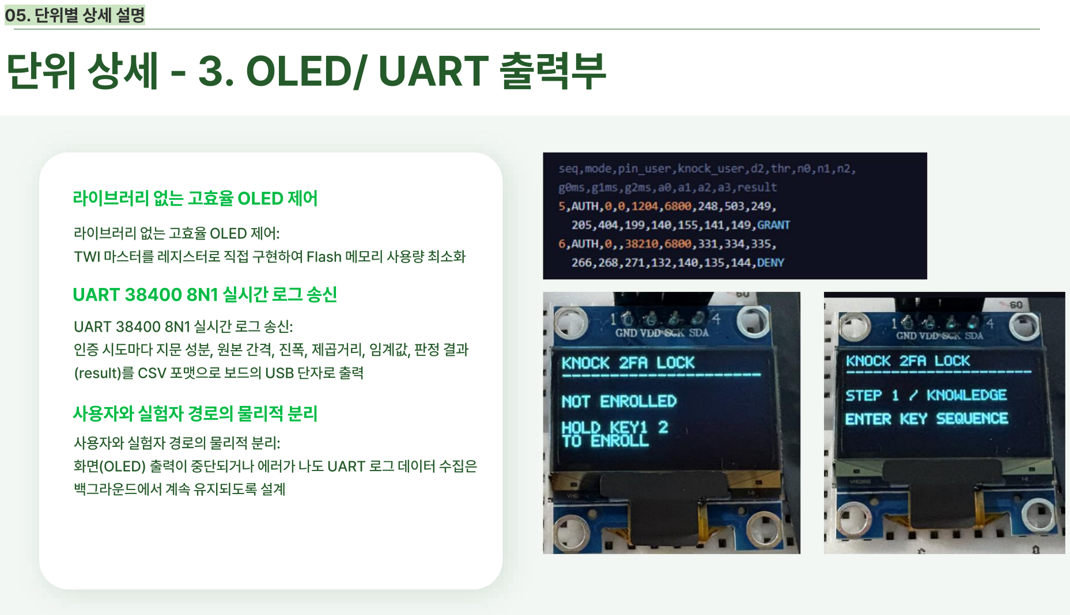
[picture p21: page 21]

레레레레레 | 레레 레레레 | OLED 레레 :
TWI 레레레레 | 레레레레레 | 레레 레레레레 | Flash 레레레 | 레레레 | 레레레
UART 38400 8N1 | 레레레 | 레레 레레 :
레레 레레레레 | 레레 레레 , 레레 레레 , 레레 , 레레레레 | , 레레레 , 레레 레레
(result) 레 CSV 레레레레 | 레레레 | USB 레레레 | 레레
레레레레 | 레레레 | 레레레 | 레레레 | 레레 :
레레 (OLED) 레레레 | 레레레레레 | 레레레 | 레레 UART 레레 레레레 | 레레레
레레레레레레레 | 레레 레레레레레 | 레레
레레레레레 | 레레 레레레 | OLED 레레
레레레레 | 레레레 | 레레레 | 레레레 | 레레
UART 38400 8N1 | 레레레 | 레레 레레
05. | 레레레 | 레레 | 레레

# 레레 레레 - 4. 레레 LED

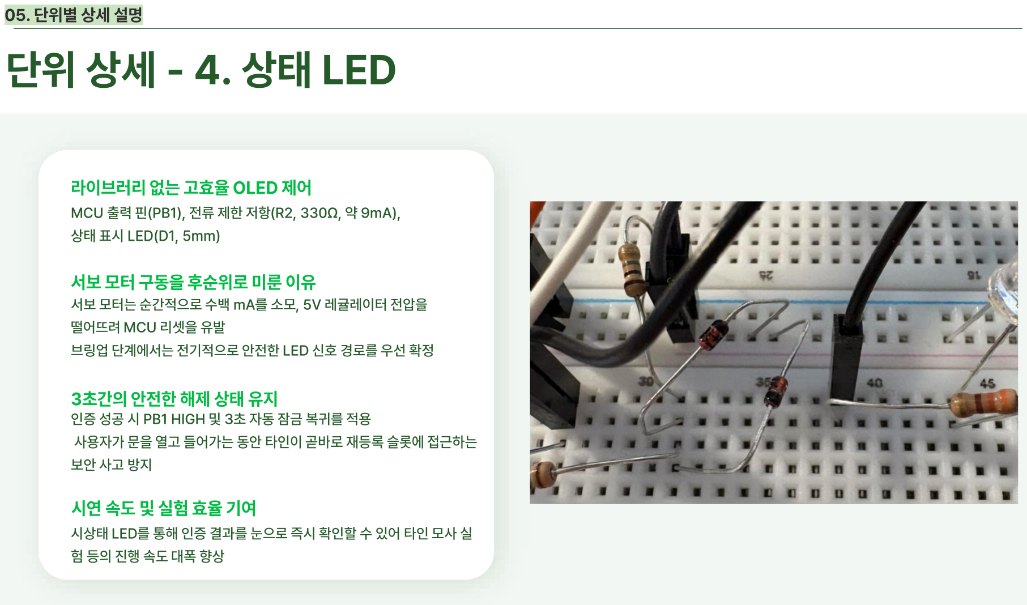
[picture p22: page 22]

MCU 레레 레 (PB1), 레레 레레 레레 (R2, 330Ω, 레 9mA), 레레 레레 LED(D1, 5mm)

레레 레레레 | 레레레레레 | 레레 mA레 레레 , 5V 레레레레레 | 레레레
레레레레 | MCU 레레레 | 레레
레레레 | 레레레레레 | 레레레레레 | 레레레 | LED 레레 레레레 | 레레 레레
레레 레레 레 PB1 HIGH 레 3레 레레 레레 레레레 | 레레
레레레레 | 레레 레레 레레레레 | 레레 레레레 | 레레레 | 레레레 | 레레레 | 레레레레
레레 레레 레레
레레레 | LED 레 레레 레레 레레레 | 레레레 | 레레 레레레 | 레 레레 레레 레레 레
레 레레 레레 레레 레레 레레
레레레레레 | 레레 레레레 | OLED 레레
레레 레레 레레레 | 레레레레 | 레레 레레
3 레레레 | 레레레 | 레레 레레 레레

### 레레 레레 레 레레 레레 레레

05. | 레레레 | 레레 | 레레

레레 레레 - 5. 레레레레 | - 레레레 | 레레

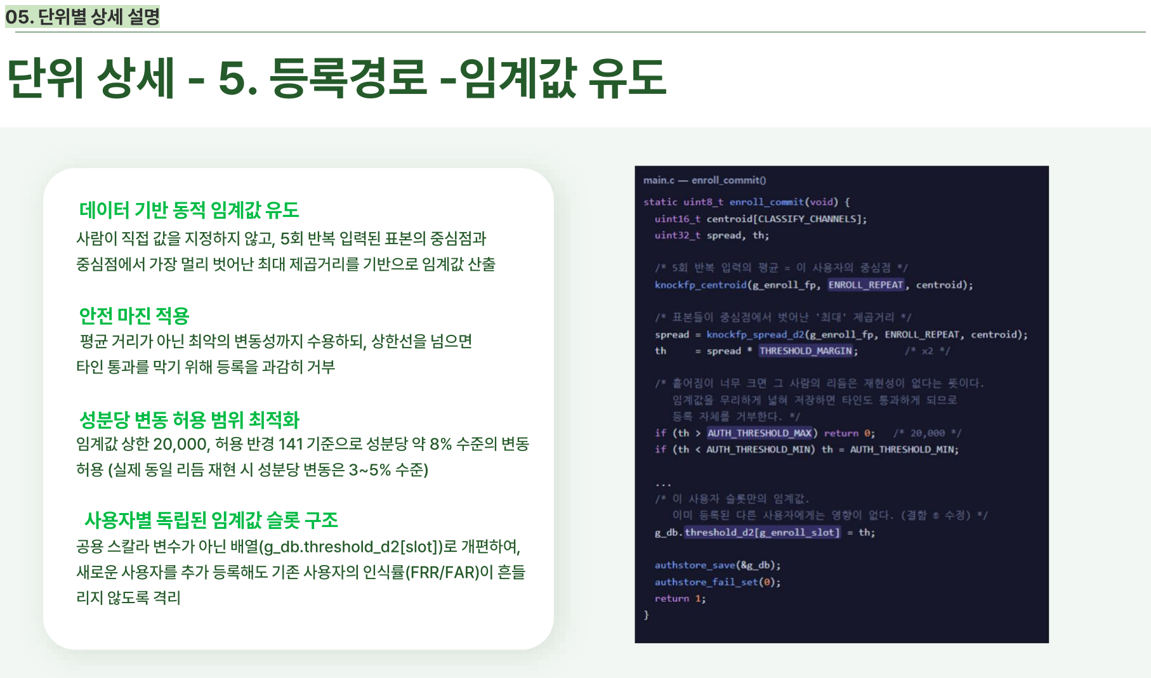
[picture p23: page 23]

레레레 | 레레 레레 레레레레 | 레레 , 5 레 레레 레레레 | 레레레 | 레레레레
레레레레레 | 레레 레레 레레레 | 레레 레레레레레 | 레레레레 | 레레레 | 레레
레레 레레레 | 레레 레레레 | 레레레레레 | 레레레레 | , 레레레레 | 레레레
레레 레레레 | 레레 레레 레레레 | 레레레 | 레레
레레레 | 레레 20,000, 레레 레레 141 레레레레 | 레레레 | 레 8% 레레레 | 레레
레레 (레레 레레 레레 레레 레 레레레 | 레레레 | 3~5% 레레 )
레레 레레레 | 레레레 | 레레 레레 (g_db.threshold_d2[slot]) 레 레레레레 | ,
레레레 | 레레레레 | 레레 레레레레 | 레레 레레레레 | 레레레 (FRR/FAR) 레 레레
레레 레레레 | 레레
레레레 | 레레 레레 레레레 | 레레

### 레레 레레 레레

레레레 | 레레 레레 레레 레레레
레레레레 | 레레레 | 레레레 | 레레 레레
05. | 레레레 | 레레 | 레레

# 레레레 레레 레레

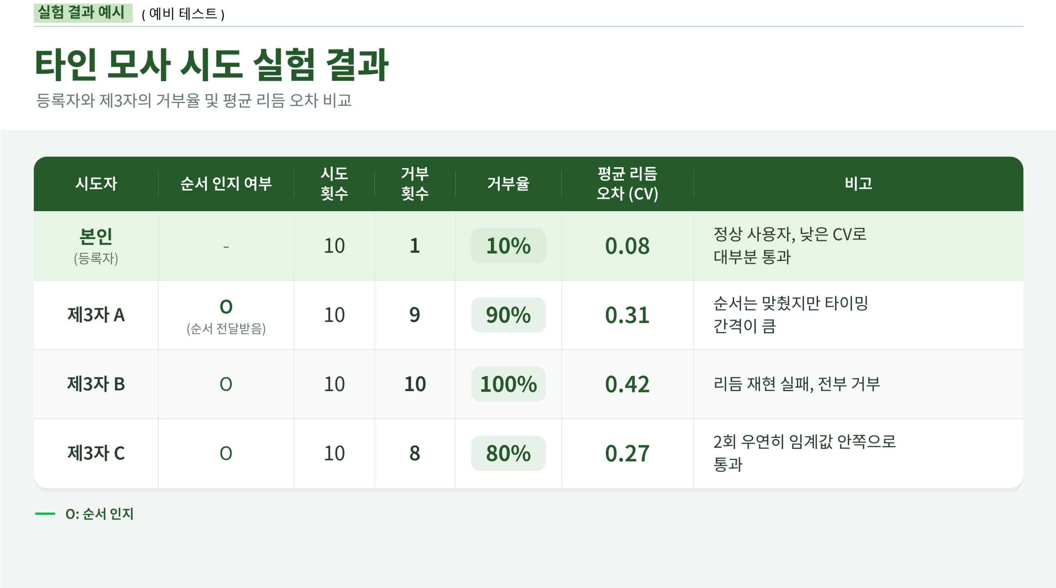
[picture p24: page 24]

( 예비 테스트 )

레레레레레레 | 레레레레 | 레레 레레

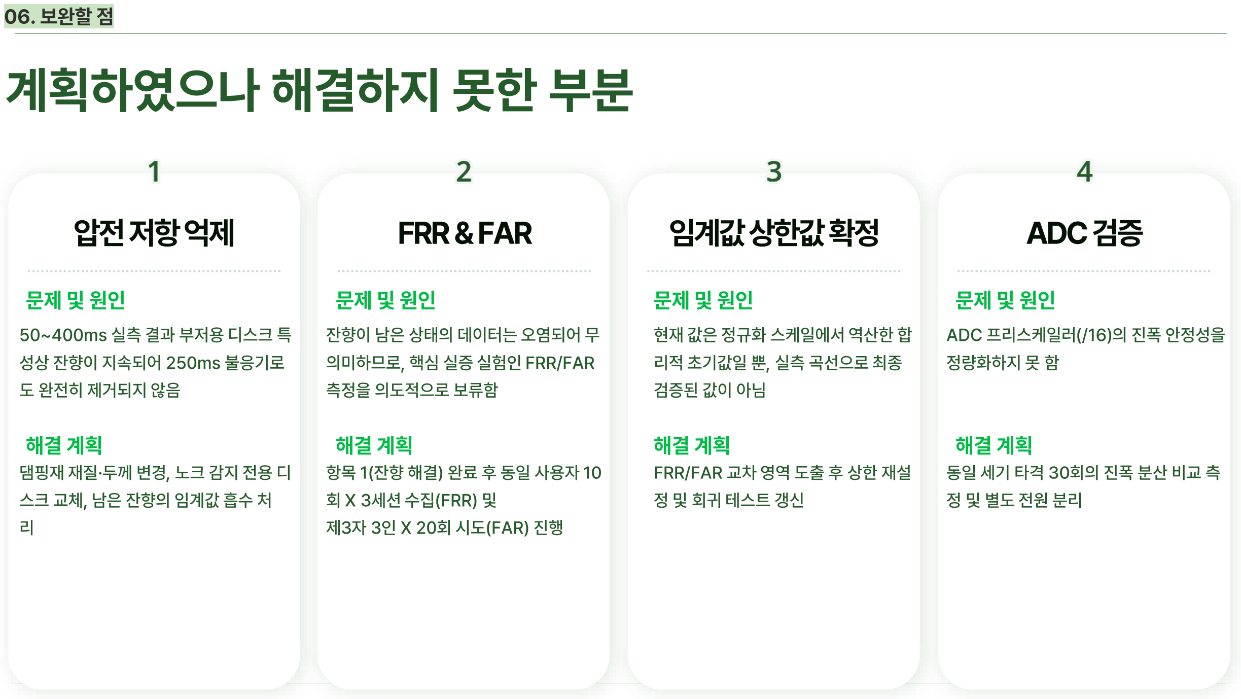
[picture p25: page 25]

50~400ms 레레 레레 레레레 | 레레레 | 레
레레 레레레 | 레레레레 | 250ms 레레레레
레 레레레 | 레레레레 | 레레
레레레 | 레레 ·레레 레레 , 레레 레레 레레 레
레레 레레 , 레레 레레레 | 레레레 | 레레 레
레

### 레레 레 레레

레레 레레 레레 | FRR & FAR | 레레레 레레레 레레 | ADC 레레

### 레레 레레

레레레 | 레레 레레레 | 레레레레 | 레레레레 | 레
레레레레레 | , 레레 레레 레레레 | FRR/FAR
레레레 | 레레레레레 | 레레레
레레 1(레레 레레 ) 레레 레 레레 레레레 | 10
레 X 3 레레 레레 (FRR) 레
레 3레 3레 X 20 레 레레 (FAR) 레레

### 레레 레 레레

### 레레 레레

레레 레레 레레레 | 레레레레레 | 레레레 | 레
레레 레레레레 | 레 , 레레 레레레레 | 레레
레레레 | 레레 레레

FRR/FAR 레레 레레 레레 레 레레 레레
레 레 레레 레레레 레레

### 레레 레 레레

### 레레 레레

ADC 레레레레레레 | (/16)레 레레 레레레레
레레레레레 | 레 레

레레 레레 레레 30 레레 레레 레레 레레 레
레 레 레레 레레 레레

### 레레 레 레레

### 레레 레레

06. | 레레레 | 레

# 레레레 레레 레레

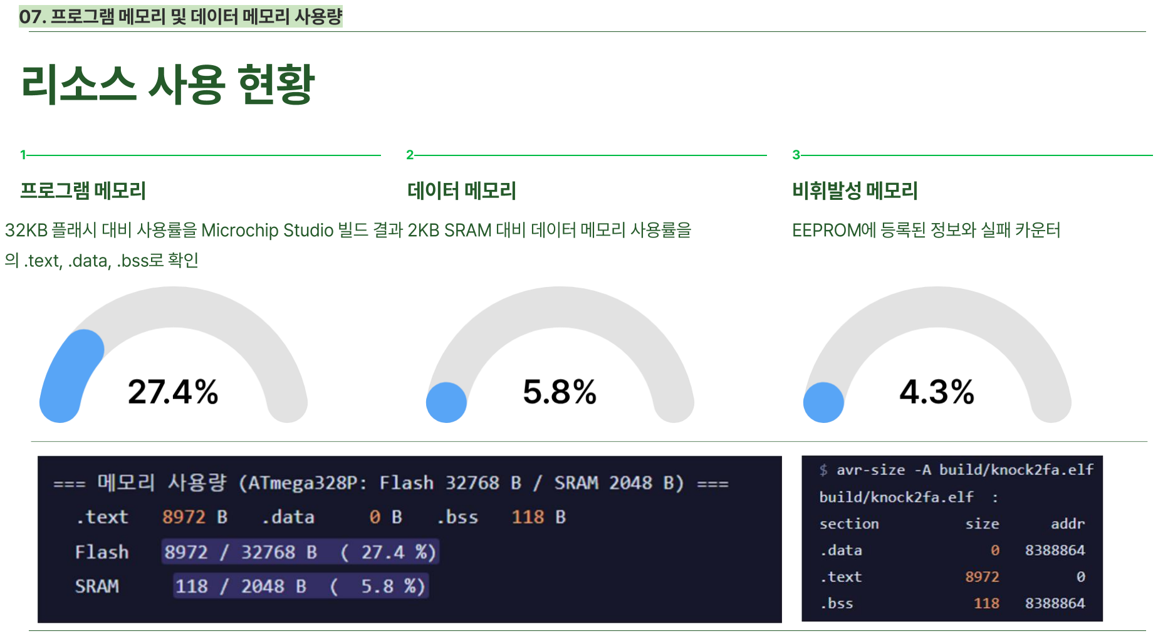
[picture p26: page 26]

1 | 2 | 3
32KB 레레레 | 레레 레레레레 | Microchip Studio 레레 레레
레 .text, .data, .bss 레 레레
레레레레 | 레레레
2KB SRAM 레레 레레레 | 레레레 | 레레레레
레레레 | 레레레
EEPROM 레 레레레 | 레레레 | 레레 레레레
레레레레 | 레레레
07. | 레레레레 | 레레레 | 레 | 레레레 | 레레레 | 레레레

# 레레레레레

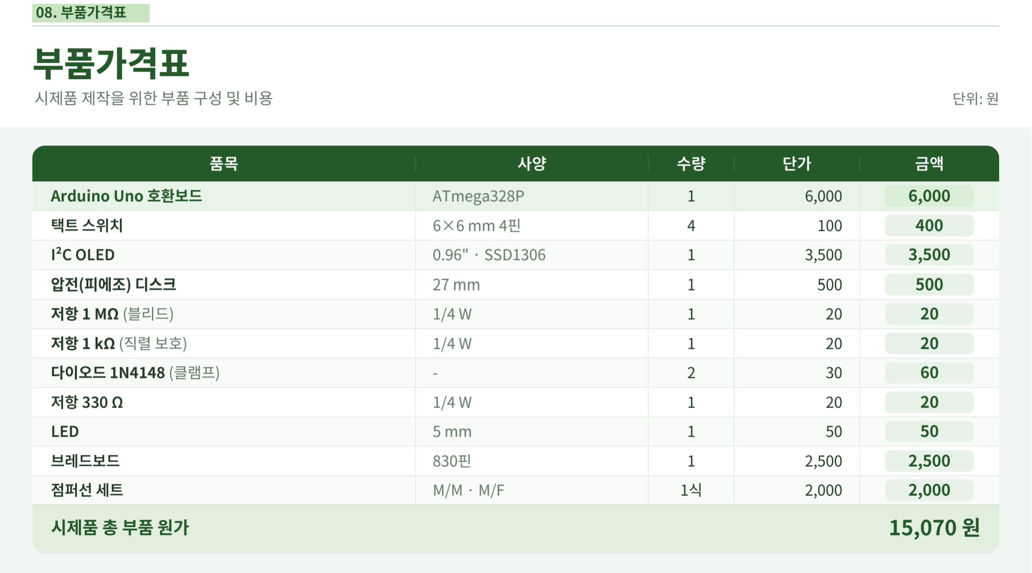
[picture p27: page 27]

08. 레레레레레

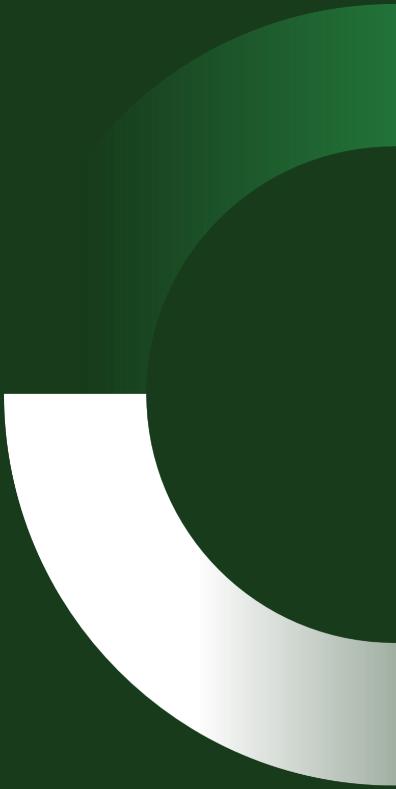
[picture p28: figure]
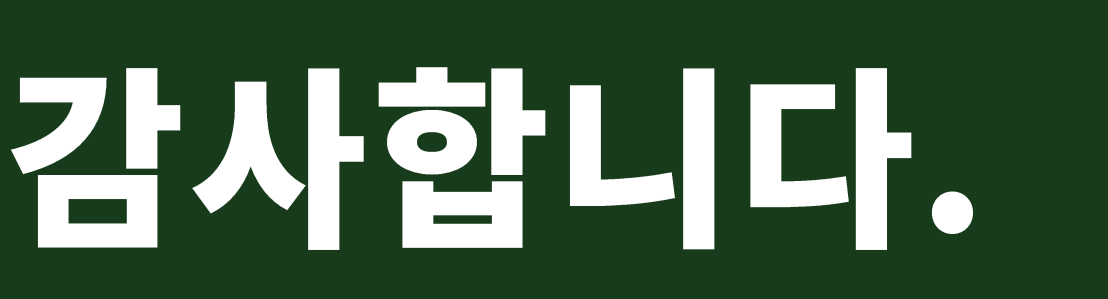
[picture p29: figure]
레레레레레
