jms1005/knock2fa/figures/png/breadboard.png

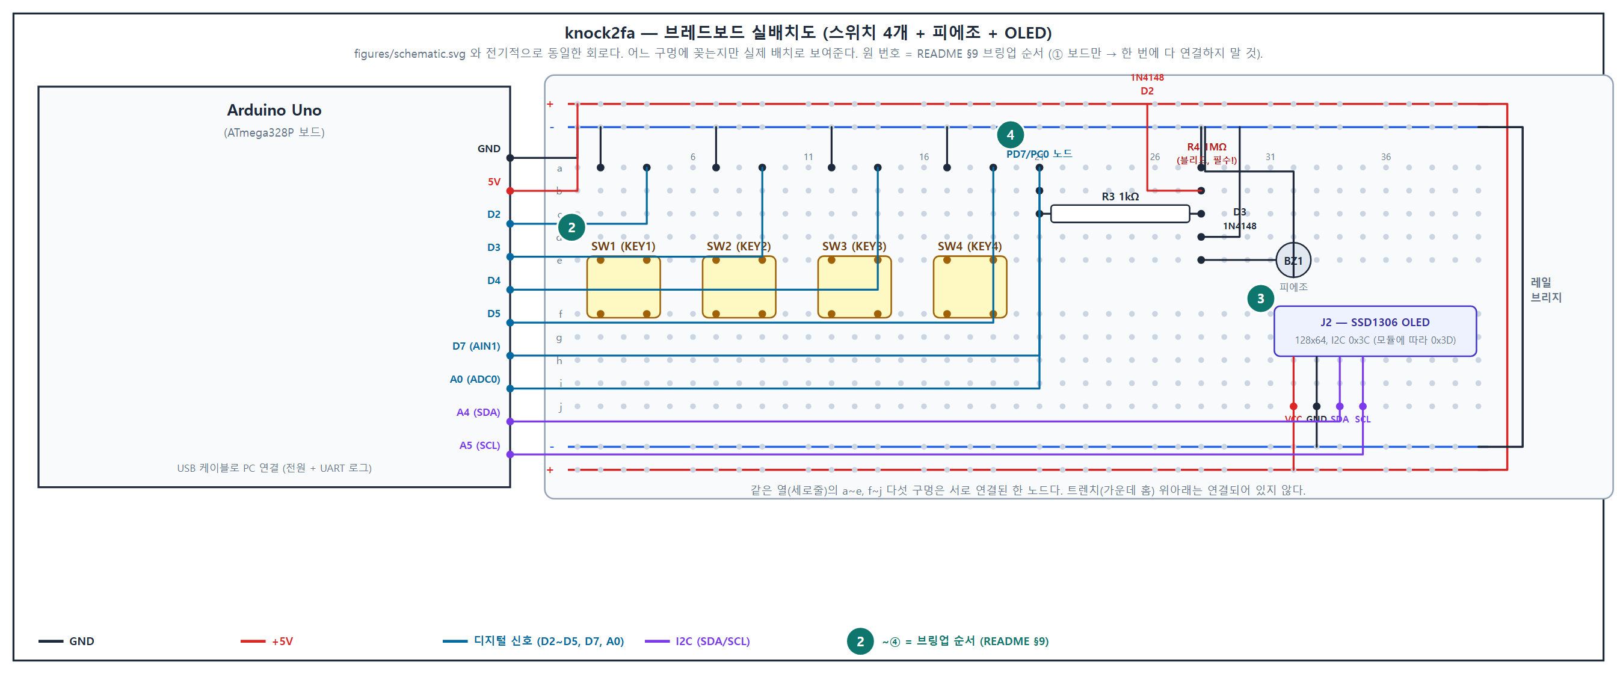
figures/png/breadboard.png
