jms1005/knock2fa/figures/png/breadboard_actuator.png

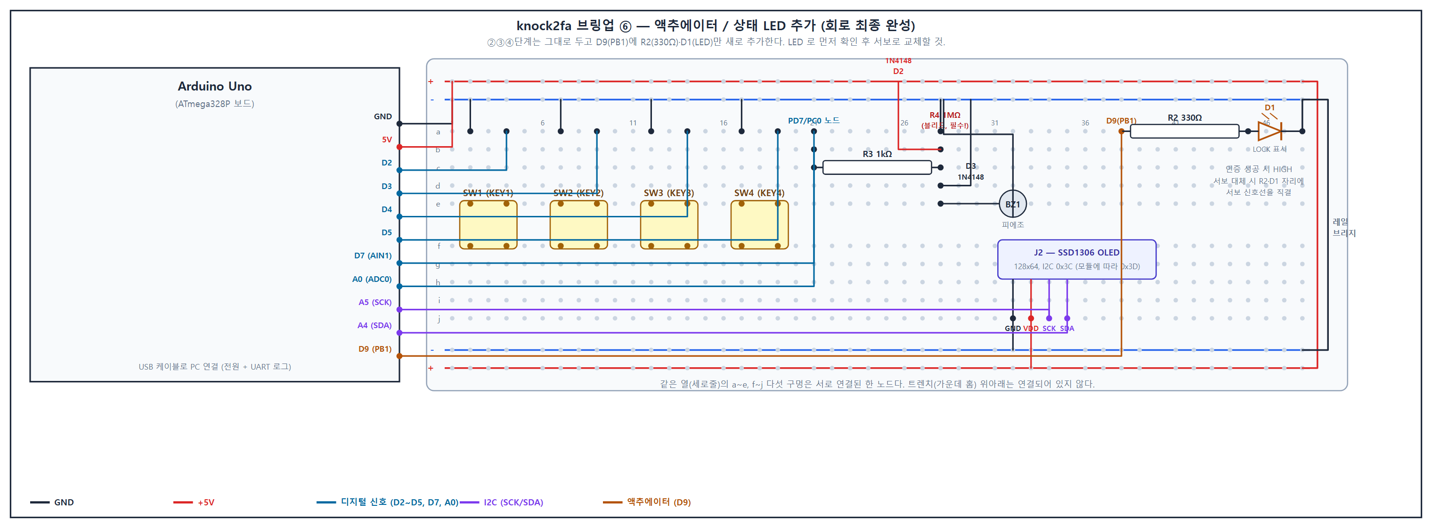
figures/png/breadboard_actuator.png
