jms1005/knock2fa/figures/png/breadboard_oled.png

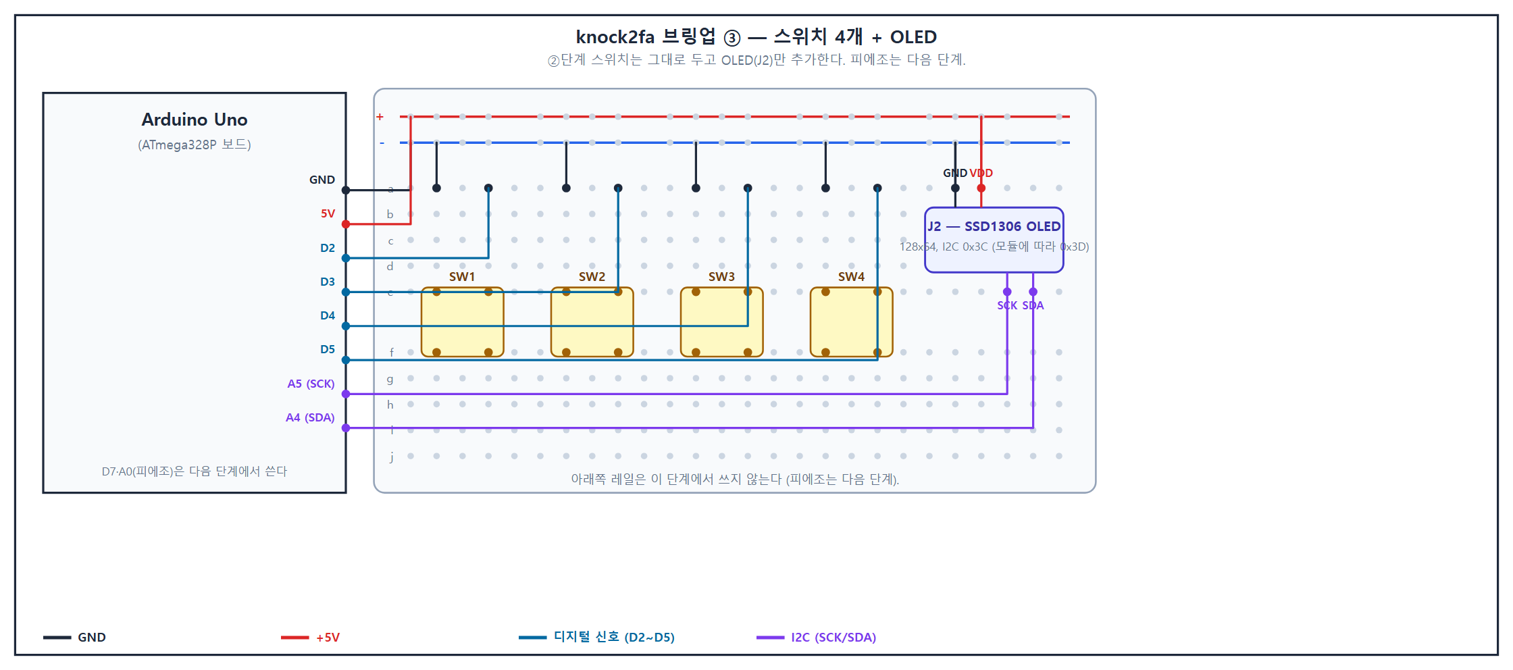
figures/png/breadboard_oled.png
