jms1005/knock2fa/figures/png/breadboard_piezo.png

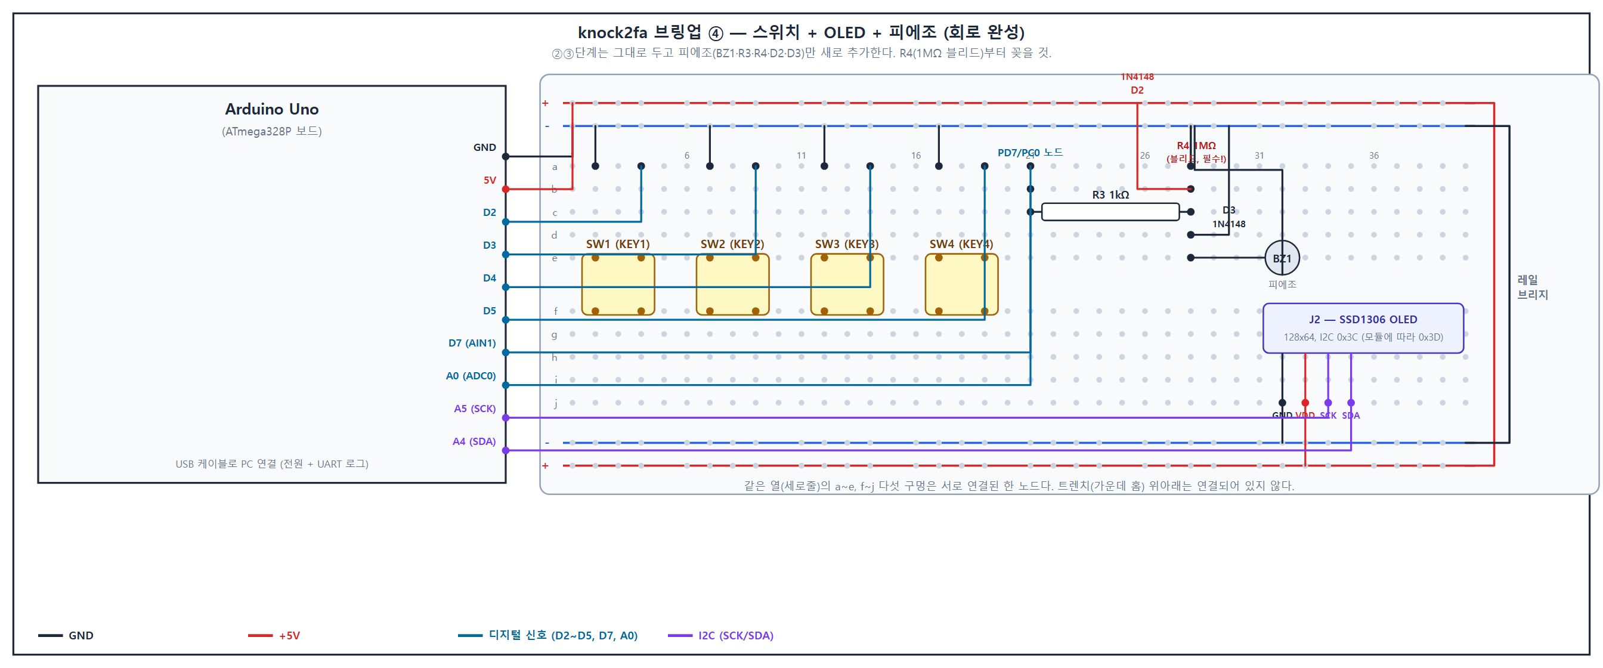
figures/png/breadboard_piezo.png
