jms1005/knock2fa/figures/png/breadboard_switches.png

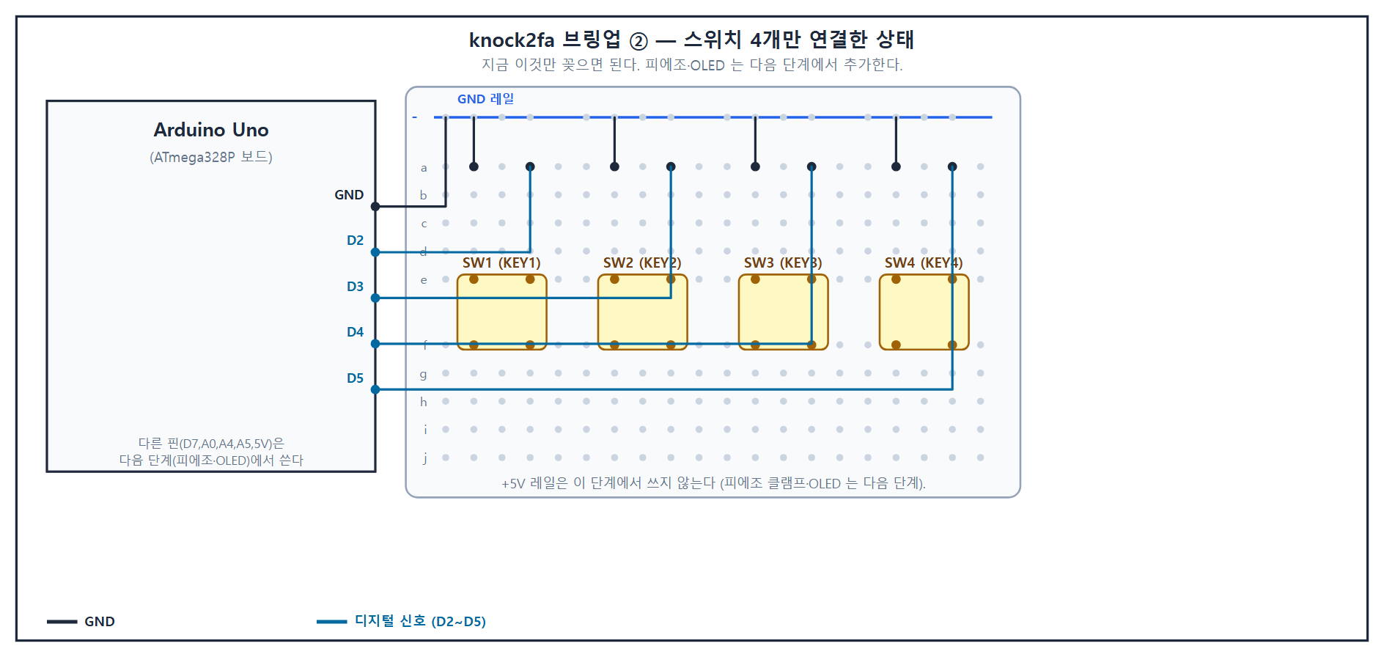
figures/png/breadboard_switches.png
