jms1005/knock2fa/figures/png/fig1_block.png

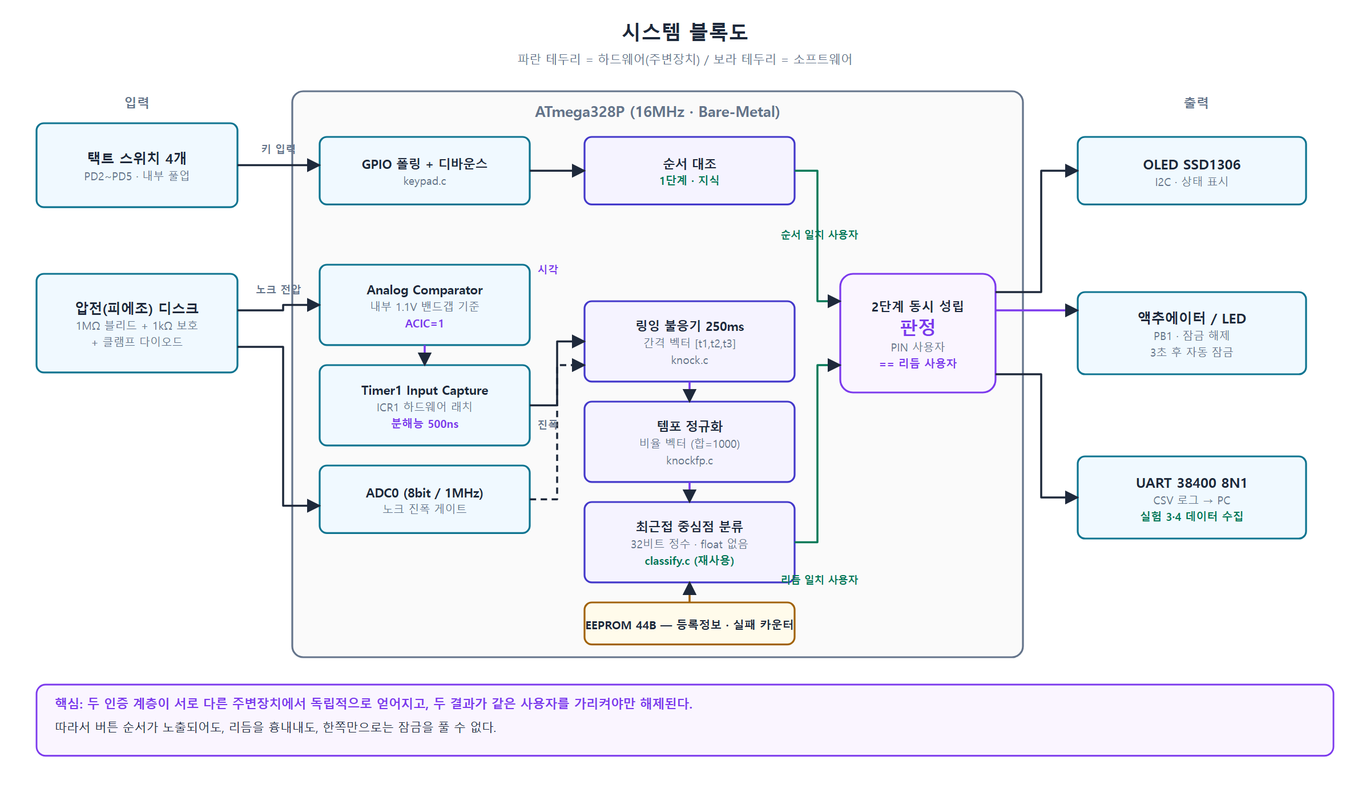
figures/png/fig1_block.png
