jms1005/knock2fa/figures/png/fig2_flow.png

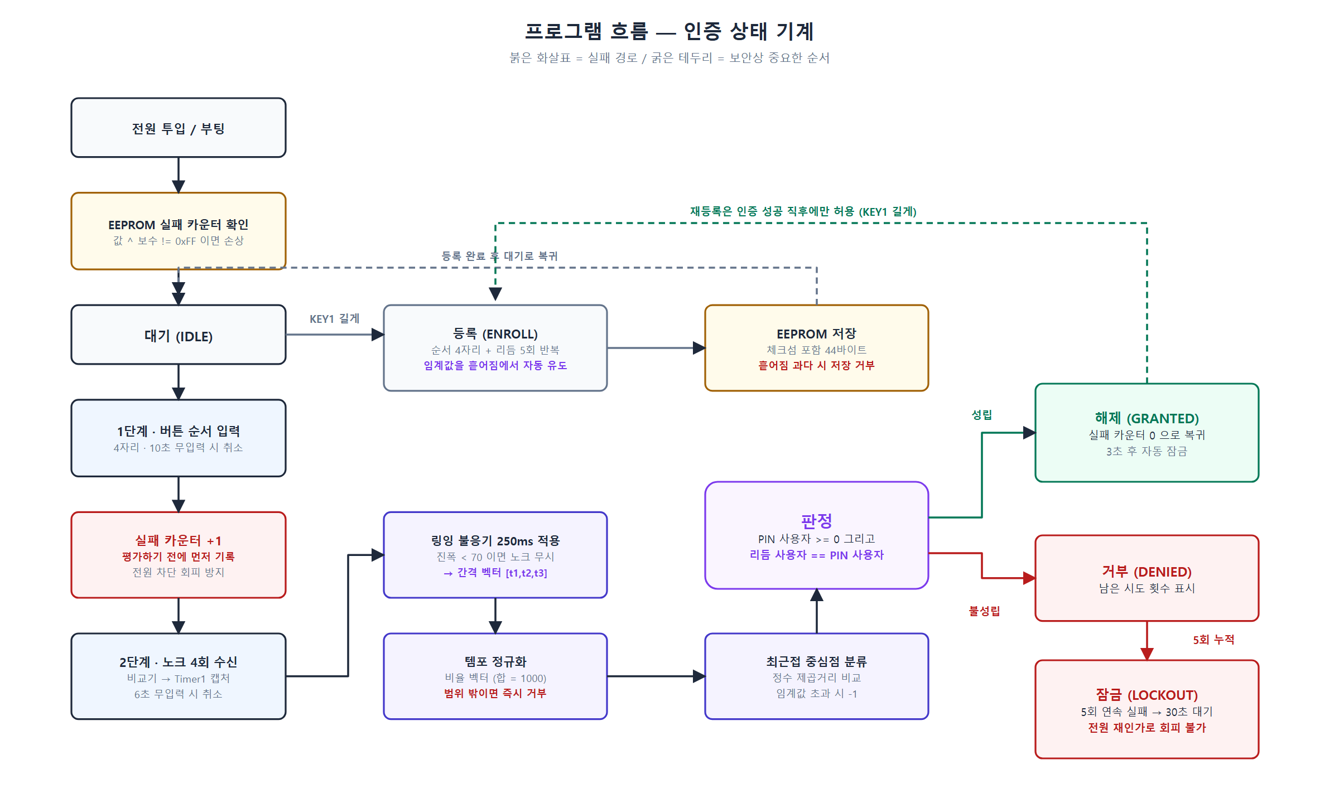
figures/png/fig2_flow.png
