jms1005/knock2fa/figures/png/schematic.png

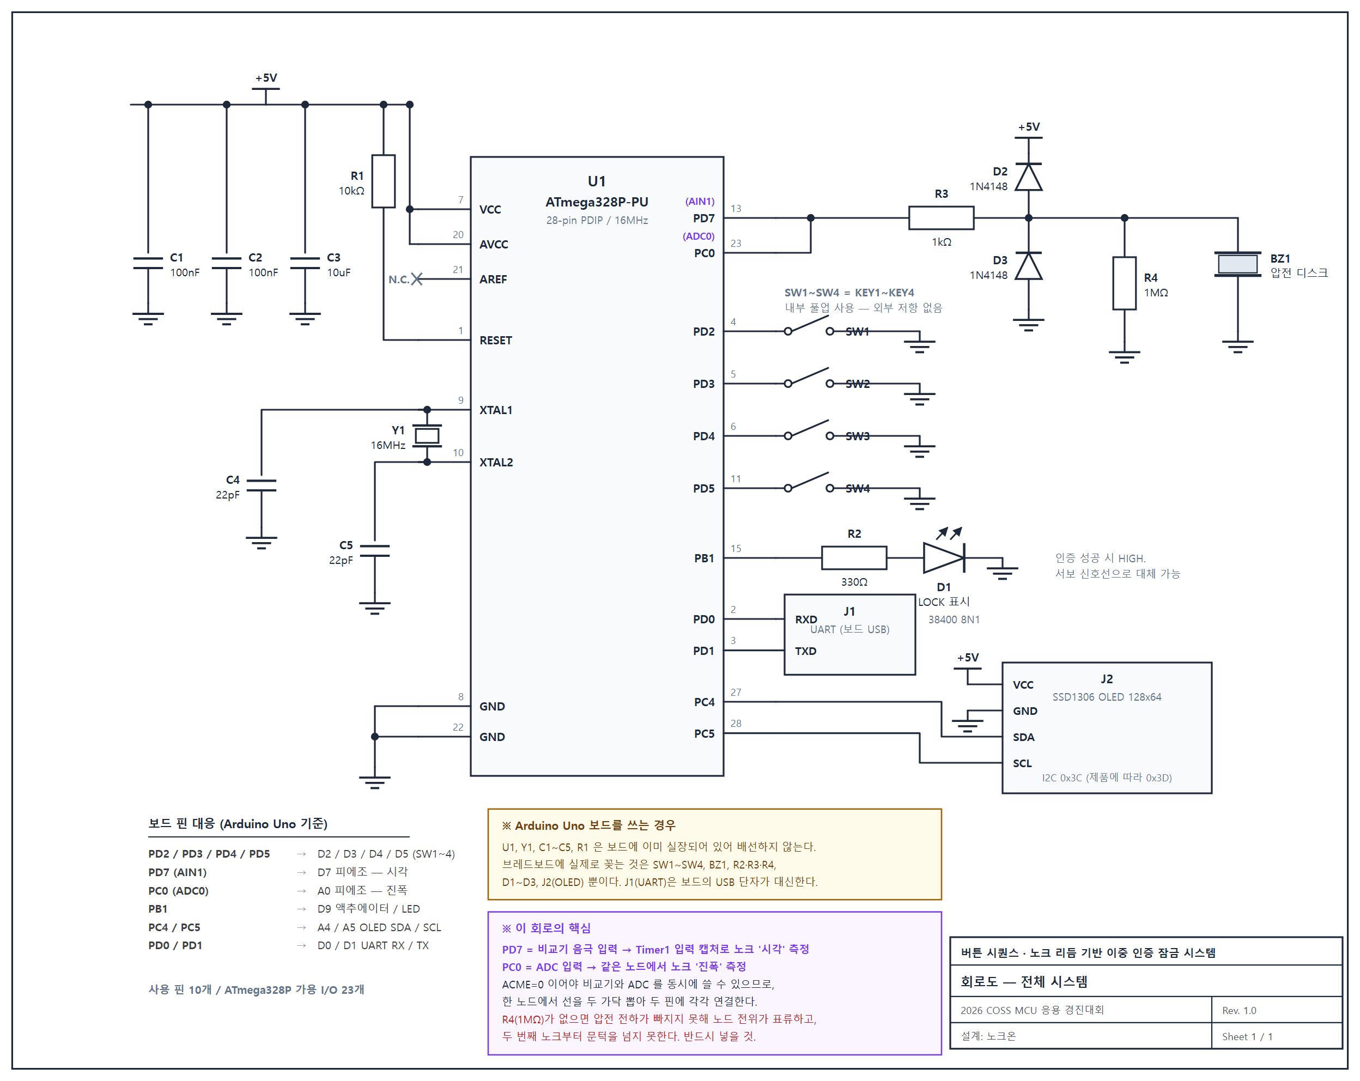
figures/png/schematic.png
