jms1005/knock2fa/figures/png/switch_detail.png

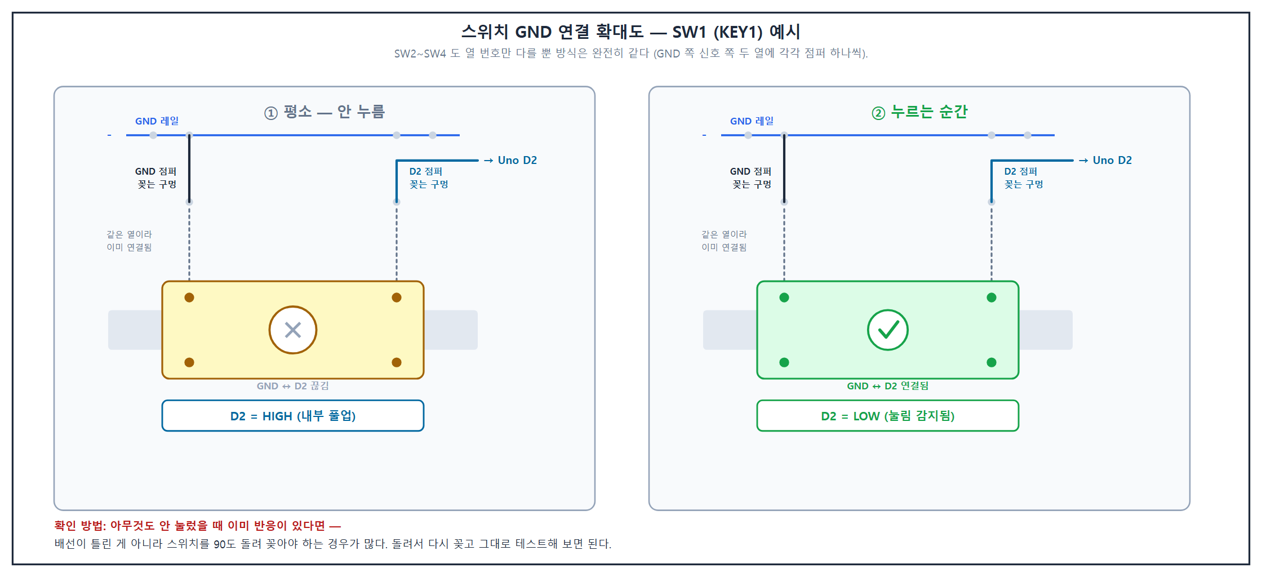
figures/png/switch_detail.png
