jms1005/knock2fa/build/test_result.txt

=== knockfp / classify 단위 테스트 (avr-gdb AVR 시뮬레이터 실행) ===

  PASS 균등 리듬 - 상태 OK
  PASS 균등 리듬 - 지문 유효
  PASS 균등 리듬 - 세 성분 동일
  PASS 균등 리듬 - 각 성분 약 333
  PASS 균등 리듬 - 합이 1000 근처
  PASS 템포 불변 - 기준 지문 (250,500,250)
  PASS 템포 불변 - 1.5배 느려도 동일
  PASS 템포 불변 - 2배 빨라도 동일
  PASS 배제 - 간격이 너무 짧음
  PASS 배제 - 짧은 간격은 지문 무효화
  PASS 배제 - 전체가 너무 짧음
  PASS 배제 - 전체가 너무 김
  PASS 배제 - 긴 입력도 지문 무효화
  PASS 경계 - 하한 바로 위는 통과
  PASS 오버플로 - 최대 길이 입력 통과
  PASS 오버플로 - 시프트 후에도 비율 보존 (200,400,400)
  PASS 오버플로 - 합이 여전히 1000 근처
  PASS 등록 - 중심점 평균
  PASS 등록 - 최대 흩어짐 계산
  PASS 판정 - 동일 리듬은 사용자 0으로 인식
  PASS 판정 - 동일 리듬의 거리는 0
  PASS 판정 - 느린 템포의 같은 리듬도 통과
  PASS 판정 - 다른 리듬은 거부 (2FA 2단계 방어)
  PASS 판정 - 임계값 상한에서도 다른 리듬은 거부
  PASS 판정 - 미등록 상태에서는 어떤 리듬도 거부
  PASS 판정 - 무효 지문은 임계값과 무관하게 거부

  검사 26개 중 실패 0개
