jms1005/knock2fa/figures/png/bringup.png

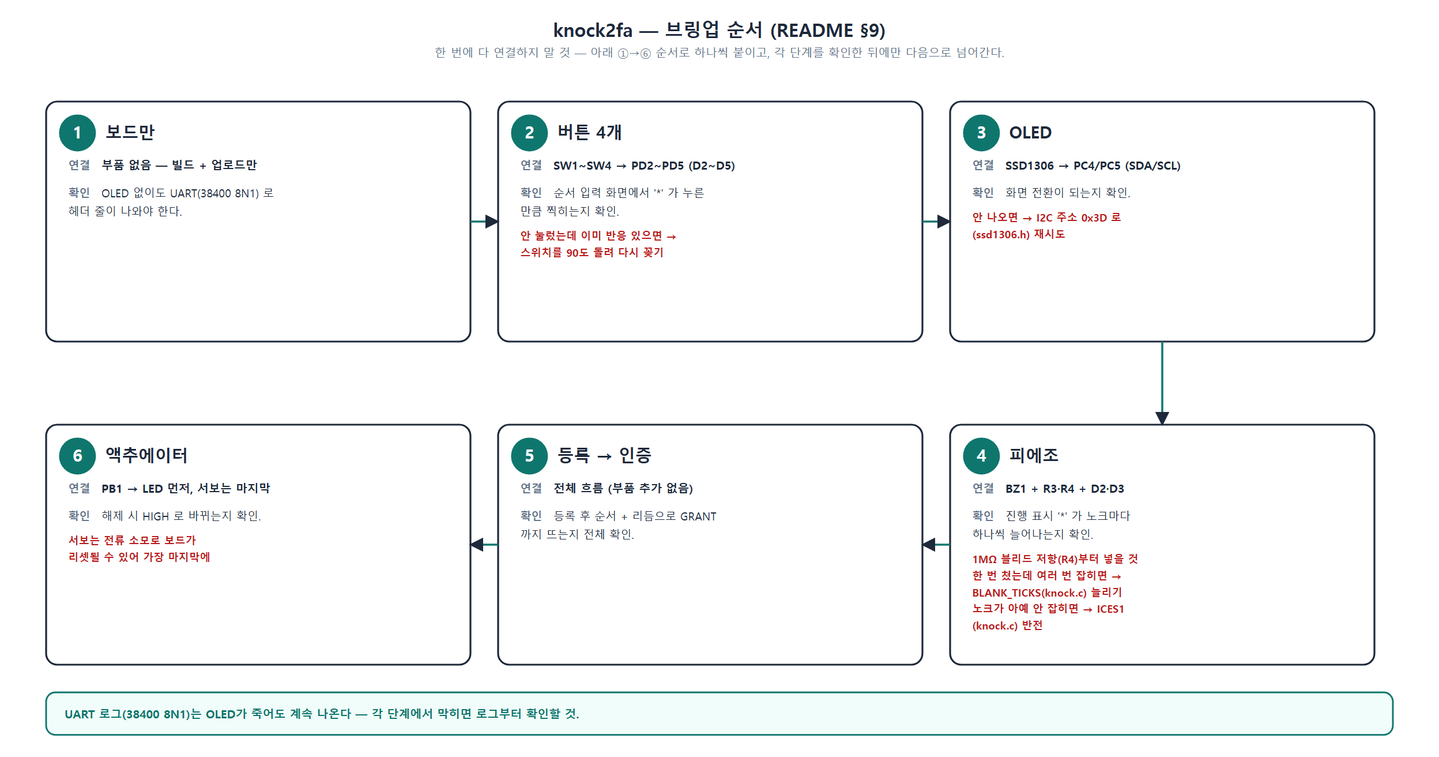
figures/png/bringup.png
