jms1005/knock2fa/제출물/회로도.pdf

U1

### ATmega328P-PU

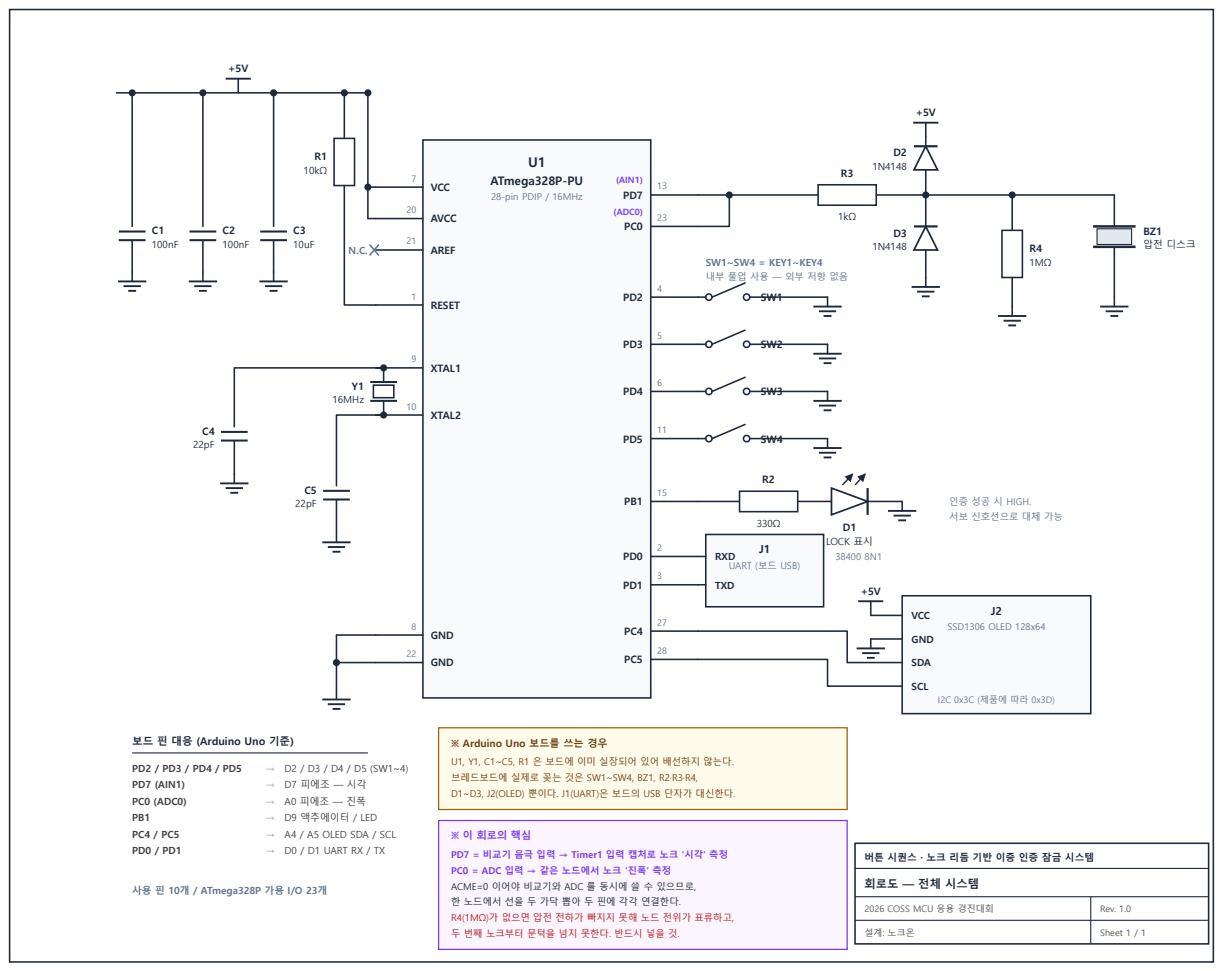
[picture p47: page 1]

SW1~SW4 = KEY1~KEY4

인증 성공 시 HIGH.
서보 신호선으로 대체 가능

보드 핀 대응 (Arduino Uno 기준)

※ Arduino Uno 보드를 쓰는 경우
U1, Y1, C1~C5, R1 은 보드에 이미 실장되어 있어 배선하지 않는다.
브레드보드에 실제로 꽂는 것은 SW1~SW4, BZ1, R2·R3·R4,
D1~D3, J2(OLED) 뿐이다. J1(UART)은 보드의 USB 단자가 대신한다.

※ 이 회로의 핵심
PD7 = 비교기 음극 입력 → Timer1 입력 캡처로 노크 '시각' 측정
PC0 = ADC 입력 → 같은 노드에서 노크 '진폭' 측정
ACME=0 이어야 비교기와 ADC 를 동시에 쓸 수 있으므로,
한 노드에서 선을 두 가닥 뽑아 두 핀에 각각 연결한다.
R4(1MΩ)가 없으면 압전 전하가 빠지지 못해 노드 전위가 표류하고,
두 번째 노크부터 문턱을 넘지 못한다. 반드시 넣을 것.

버튼 시퀀스 · 노크 리듬 기반 이중 인증 잠금 시스템
회로도 — 전체 시스템

2026 COSS MCU 응용 경진대회
