jms1005/knock2fa/tools/make_breadboard_actuator.py

# -*- coding: utf-8 -*-
"""
make_breadboard_actuator.py — 브링업 ⑥단계(액추에이터/상태 LED) 전용 브레드보드도

②(스위치)·③(OLED)·④(피에조)는 이미 꽂혀 있다고 보고 그대로 두고, PB1(D9)에
저항(R2)과 LED(D1)만 새로 추가한 상태를 그린다. 이 그림으로 회로가 최종
완성된다. 서보로 대체하는 경우 R2·D1 자리에 서보 신호선을 D9에 직접
연결하면 된다(회로도 참고, 전류 소모가 커 가장 마지막에 연결할 것).

전기 규칙·표기법은 make_breadboard_piezo.py 와 동일하다.

실행:  python tools/make_breadboard_actuator.py
출력:  figures/breadboard_actuator.svg
"""

import io
import os
from xml.sax.saxutils import escape
import xml.etree.ElementTree as ET

W, H = 1900, 700
FONT = "'Malgun Gothic','맑은 고딕','Noto Sans KR',sans-serif"
INK = "#1e293b"
MUTE = "#64748b"
HOLE = "#cbd5e1"
RAIL_RED = "#dc2626"
RAIL_BLUE = "#2563eb"
WIRE_GND = "#1e293b"
WIRE_VCC = "#dc2626"
WIRE_SIG = "#0369a1"
WIRE_I2C = "#7c3aed"
WIRE_ACT = "#b45309"
WARN = "#b91c1c"

out = []


def add(s):
    out.append(s)


def wire(pts, color=INK, w=2.2):
    d = " ".join("%g,%g" % p for p in pts)
    add('<polyline points="%s" fill="none" stroke="%s" stroke-width="%g" '
        'stroke-linecap="round" stroke-linejoin="round"/>' % (d, color, w))


def line(x1, y1, x2, y2, w=2, color=INK):
    add('<line x1="%g" y1="%g" x2="%g" y2="%g" stroke="%s" stroke-width="%g"/>'
        % (x1, y1, x2, y2, color, w))


def txt(x, y, s, size=12, anchor="start", weight="400", color=INK):
    add('<text x="%g" y="%g" font-size="%g" text-anchor="%s" font-weight="%s" '
        'fill="%s">%s</text>' % (x, y, size, anchor, weight, color, escape(s)))


def box(x, y, w, h, fill="#ffffff", stroke=INK, sw=2, rx=0):
    add('<rect x="%g" y="%g" width="%g" height="%g" rx="%g" fill="%s" '
        'stroke="%s" stroke-width="%g"/>' % (x, y, w, h, rx, fill, stroke, sw))


def hole(x, y):
    add('<circle cx="%g" cy="%g" r="3" fill="%s"/>' % (x, y, HOLE))


def dot(x, y, color=INK):
    add('<circle cx="%g" cy="%g" r="4" fill="%s"/>' % (x, y, color))


def led_h(xa, y, ref, val, color=INK):
    """가로 LED. 애노드 왼쪽 / 캐소드 오른쪽. 반환: 우측(캐소드) x."""
    L, hh = 30, 12
    xb = xa + L
    add('<path d="M %g %g L %g %g L %g %g Z" fill="none" stroke="%s" '
        'stroke-width="2.2"/>' % (xa, y - hh, xa, y + hh, xb, y, color))
    line(xb, y - hh, xb, y + hh, 2.6, color)
    cx = xa + L / 2.0
    for k in (0, 1):
        ox = cx - 6 + k * 11
        line(ox - 5, y - hh - 12, ox + 5, y - hh - 4, 1.4, color)
    txt(cx, y - hh - 16, ref, 10.5, "middle", "700", color)
    txt(cx, y + hh + 15, val, 9.5, "middle", "400", MUTE)
    return xb


# ---------------------------- 브레드보드 격자 ----------------------------

COLS = 48
COL_PITCH = 24
ROW_PITCH = 24
BB_X0 = 600
BB_Y0 = 108
RAIL_GAP = 18
TRENCH = 32


def x_of(c):
    return BB_X0 + c * COL_PITCH


Y_RAIL_T_PLUS = BB_Y0
Y_RAIL_T_MINUS = BB_Y0 + ROW_PITCH
Y_A = Y_RAIL_T_MINUS + ROW_PITCH + RAIL_GAP
ROWS_TOP = {r: Y_A + i * ROW_PITCH for i, r in enumerate("abcde")}
Y_F0 = ROWS_TOP["e"] + ROW_PITCH + TRENCH
ROWS_BOT = {r: Y_F0 + i * ROW_PITCH for i, r in enumerate("fghij")}
Y_RAIL_B_MINUS = ROWS_BOT["j"] + ROW_PITCH + RAIL_GAP
Y_RAIL_B_PLUS = Y_RAIL_B_MINUS + ROW_PITCH

BB_X1 = x_of(COLS - 1)
BB_Y1 = Y_RAIL_B_PLUS

# ---- 부품이 꽂히는 열 번호 (0-based) ----
SW_COLS = [(1, 3), (6, 8), (11, 13), (16, 18)]   # (GND 열, 신호 열) x KEY1~4
MCU_TAP_COL = 20     # PD7(AIN1) 과 PC0(ADC0) 이 함께 물리는 열
PZ_NODE_COL = 27     # R3 건너편 "피에조 노드" 열
OLED_COLS = (31, 32, 33, 34)   # 실물 모듈 순서: GND, VDD, SCK, SDA
ACT_IN_COL = 37      # D9(PB1) 이 들어오는 열
ACT_OUT_COL = 44     # R2 건너편, LED 애노드가 물리는 열
ACT_GND_COL = 47     # LED 캐소드가 GND 로 빠지는 열


def draw_board():
    box(BB_X0 - 34, BB_Y0 - 30, (BB_X1 - BB_X0) + 34 + 60, (BB_Y1 - BB_Y0) + 60,
        "#f8fafc", "#94a3b8", 1.6, 10)

    for y, color, label in ((Y_RAIL_T_PLUS, RAIL_RED, "+"),
                            (Y_RAIL_T_MINUS, RAIL_BLUE, "-"),
                            (Y_RAIL_B_MINUS, RAIL_BLUE, "-"),
                            (Y_RAIL_B_PLUS, RAIL_RED, "+")):
        line(x_of(0) - 10, y, x_of(COLS - 1) + 10, y, 2.2, color)
        txt(x_of(0) - 24, y + 4, label, 13, "end", "700", color)
        for c in range(COLS):
            if c % 5 == 4:
                continue
            hole(x_of(c), y)

    for rows in (ROWS_TOP, ROWS_BOT):
        for r, y in rows.items():
            txt(x_of(0) - 16, y + 4, r, 10.5, "end", "400", MUTE)
            for c in range(COLS):
                hole(x_of(c), y)

    for c in range(0, COLS, 5):
        txt(x_of(c), Y_A - 8, str(c + 1), 9.5, "middle", "400", MUTE)

    txt((BB_X0 + BB_X1) / 2.0, BB_Y1 + 26,
        "같은 열(세로줄)의 a~e, f~j 다섯 구멍은 서로 연결된 한 노드다. "
        "트렌치(가운데 홈) 위아래는 연결되어 있지 않다.",
        11.5, "middle", "400", MUTE)


def draw_rail_bridges():
    xb1 = x_of(COLS - 1) + 20
    xb2 = xb1 + 14
    wire([(x_of(COLS - 1), Y_RAIL_T_PLUS), (xb1, Y_RAIL_T_PLUS),
          (xb1, Y_RAIL_B_PLUS), (x_of(COLS - 1), Y_RAIL_B_PLUS)], WIRE_VCC, 2.2)
    wire([(x_of(COLS - 1), Y_RAIL_T_MINUS), (xb2, Y_RAIL_T_MINUS),
          (xb2, Y_RAIL_B_MINUS), (x_of(COLS - 1), Y_RAIL_B_MINUS)], WIRE_GND, 2.2)
    txt(xb2 + 6, (Y_RAIL_T_PLUS + Y_RAIL_B_PLUS) / 2.0, "레일", 10.5, "start", "700", MUTE)
    txt(xb2 + 6, (Y_RAIL_T_PLUS + Y_RAIL_B_PLUS) / 2.0 + 15, "브리지", 10.5, "start", "700", MUTE)


def draw_switch(colA, colB, label):
    xa, xb = x_of(colA), x_of(colB)
    ye, yf = ROWS_TOP["e"], ROWS_BOT["f"]
    box(xa - 14, ye - 4, (xb - xa) + 28, (yf - ye) + 8, "#fef9c3", "#a16207", 1.6, 6)
    for cx, cy in ((xa, ye), (xb, ye), (xa, yf), (xb, yf)):
        dot(cx, cy, "#a16207")
    txt((xa + xb) / 2.0, ye - 10, label, 12, "middle", "700", "#713f12")


def draw_switches():
    """②단계에서 이미 꽂혀 있는 스위치. 그대로 보여준다."""
    for i, (gcol, scol) in enumerate(SW_COLS):
        draw_switch(gcol, scol, "SW%d (KEY%d)" % (i + 1, i + 1))
        wire([(x_of(gcol), ROWS_TOP["a"]), (x_of(gcol), Y_RAIL_T_MINUS)], WIRE_GND, 2)
        dot(x_of(gcol), ROWS_TOP["a"])
        dot(x_of(scol), ROWS_TOP["a"])


def draw_piezo():
    """④단계에서 이미 꽂혀 있는 피에조. 그대로 보여준다."""
    dot(x_of(MCU_TAP_COL), ROWS_TOP["a"])
    dot(x_of(MCU_TAP_COL), ROWS_TOP["b"])
    txt(x_of(MCU_TAP_COL), ROWS_TOP["a"] - 10, "PD7/PC0 노드", 10.5, "middle", "700", WIRE_SIG)

    r3y = ROWS_TOP["c"]
    bw = (x_of(PZ_NODE_COL) - x_of(MCU_TAP_COL)) - 24
    box(x_of(MCU_TAP_COL) + 12, r3y - 9, bw, 18, "#ffffff", INK, 1.6, 3)
    line(x_of(MCU_TAP_COL), r3y, x_of(MCU_TAP_COL) + 12, r3y, 2, INK)
    line(x_of(PZ_NODE_COL) - 12, r3y, x_of(PZ_NODE_COL), r3y, 2, INK)
    dot(x_of(MCU_TAP_COL), r3y)
    dot(x_of(PZ_NODE_COL), r3y)
    txt((x_of(MCU_TAP_COL) + x_of(PZ_NODE_COL)) / 2.0, r3y - 14, "R3 1kΩ",
        11, "middle", "700")

    dot(x_of(PZ_NODE_COL), ROWS_TOP["a"])
    wire([(x_of(PZ_NODE_COL), ROWS_TOP["a"]), (x_of(PZ_NODE_COL), Y_RAIL_T_MINUS)],
         WIRE_GND, 2.2)
    txt(x_of(PZ_NODE_COL) + 6, ROWS_TOP["a"] - 18,
        "R4 1MΩ", 10.5, "middle", "700", WARN)
    txt(x_of(PZ_NODE_COL) + 6, ROWS_TOP["a"] - 4,
        "(블리드, 필수!)", 9.5, "middle", "700", WARN)

    d2x = x_of(PZ_NODE_COL) - 56
    dot(x_of(PZ_NODE_COL), ROWS_TOP["b"])
    wire([(x_of(PZ_NODE_COL), ROWS_TOP["b"]), (d2x, ROWS_TOP["b"]),
          (d2x, Y_RAIL_T_PLUS)], WIRE_VCC, 2)
    txt(d2x, Y_RAIL_T_PLUS - 10, "D2", 10.5, "middle", "700", WIRE_VCC)
    txt(d2x, Y_RAIL_T_PLUS - 24, "1N4148", 9.5, "middle", "700", WIRE_VCC)

    d3x = x_of(PZ_NODE_COL) + 40
    dot(x_of(PZ_NODE_COL), ROWS_TOP["d"])
    wire([(x_of(PZ_NODE_COL), ROWS_TOP["d"]), (d3x, ROWS_TOP["d"]),
          (d3x, Y_RAIL_T_MINUS)], WIRE_GND, 2)
    txt(d3x, ROWS_TOP["d"] - 22, "D3", 10.5, "middle", "700", INK)
    txt(d3x, ROWS_TOP["d"] - 8, "1N4148", 9.5, "middle", "700", INK)

    dot(x_of(PZ_NODE_COL), ROWS_TOP["e"])
    bz_x, bz_y = x_of(PZ_NODE_COL) + 96, ROWS_TOP["e"]
    line(x_of(PZ_NODE_COL), ROWS_TOP["e"], bz_x - 18, bz_y, 2, INK)
    add('<circle cx="%g" cy="%g" r="18" fill="#e2e8f0" stroke="%s" stroke-width="1.6"/>'
        % (bz_x, bz_y, INK))
    txt(bz_x, bz_y + 5, "BZ1", 11, "middle", "700")
    txt(bz_x, bz_y + 32, "피에조", 10, "middle", "400", MUTE)
    wire([(bz_x, bz_y + 18), (bz_x, Y_RAIL_T_MINUS + 46), (x_of(PZ_NODE_COL) + 4,
          Y_RAIL_T_MINUS + 46), (x_of(PZ_NODE_COL) + 4, Y_RAIL_T_MINUS)], WIRE_GND, 2)


def draw_oled():
    """③단계에서 이미 꽂혀 있는 OLED. 그대로 보여준다(실물 라벨 GND/VDD/SCK/SDA)."""
    gnd_c, vdd_c, sck_c, sda_c = OLED_COLS
    ow, oh = 210, 52
    ox = x_of(OLED_COLS[0]) - 20
    oy = ROWS_BOT["g"] - oh + 20
    box(ox, oy, ow, oh, "#eef2ff", "#4338ca", 1.6, 6)
    txt(ox + ow / 2.0, oy + 21, "J2 — SSD1306 OLED", 11.5, "middle", "700", "#3730a3")
    txt(ox + ow / 2.0, oy + 39, "128x64, I2C 0x3C (모듈에 따라 0x3D)", 10, "middle",
        "400", MUTE)

    labels = ["GND", "VDD", "SCK", "SDA"]
    colors = [WIRE_GND, WIRE_VCC, WIRE_I2C, WIRE_I2C]
    for lab, col, c in zip(labels, colors, OLED_COLS):
        hx = x_of(c)
        dot(hx, ROWS_BOT["j"], col)
        line(hx, oy + oh, hx, ROWS_BOT["j"], 2, col)
        txt(hx, ROWS_BOT["j"] + 17, lab, 9.5, "middle", "600", col)

    wire([(x_of(gnd_c), ROWS_BOT["j"]), (x_of(gnd_c), Y_RAIL_B_MINUS)], WIRE_GND, 2)
    wire([(x_of(vdd_c), ROWS_BOT["j"]), (x_of(vdd_c), Y_RAIL_B_PLUS)], WIRE_VCC, 2)


def draw_actuator():
    """⑥단계에서 새로 추가하는 부분: D9(PB1) -> R2 330Ω -> D1(LED) -> GND."""
    y = ROWS_TOP["a"]
    dot(x_of(ACT_IN_COL), y, WIRE_ACT)
    txt(x_of(ACT_IN_COL), y - 10, "D9(PB1)", 10.5, "middle", "700", WIRE_ACT)

    bw = (x_of(ACT_OUT_COL) - x_of(ACT_IN_COL)) - 24
    box(x_of(ACT_IN_COL) + 12, y - 9, bw, 18, "#ffffff", INK, 1.6, 3)
    line(x_of(ACT_IN_COL), y, x_of(ACT_IN_COL) + 12, y, 2, INK)
    line(x_of(ACT_OUT_COL) - 12, y, x_of(ACT_OUT_COL), y, 2, INK)
    dot(x_of(ACT_OUT_COL), y)
    txt((x_of(ACT_IN_COL) + x_of(ACT_OUT_COL)) / 2.0, y - 14, "R2 330Ω",
        11, "middle", "700")

    xb = led_h(x_of(ACT_OUT_COL) + 14, y, "D1", "LOCK 표시", WIRE_ACT)
    line(x_of(ACT_OUT_COL), y, x_of(ACT_OUT_COL) + 14, y, 2, INK)
    dot(x_of(ACT_GND_COL), y)
    wire([(xb, y), (x_of(ACT_GND_COL), y)], INK, 2)
    wire([(x_of(ACT_GND_COL), y), (x_of(ACT_GND_COL), Y_RAIL_T_MINUS)], WIRE_GND, 2.2)

    note_x = x_of(ACT_OUT_COL) + 14
    txt(note_x, ROWS_TOP["c"] + 6,
        "인증 성공 시 HIGH", 10.5, "middle", "400", MUTE)
    txt(note_x, ROWS_TOP["c"] + 22,
        "서보 대체 시 R2·D1 자리에", 10, "middle", "400", MUTE)
    txt(note_x, ROWS_TOP["c"] + 37,
        "서보 신호선을 직결", 10, "middle", "400", MUTE)


def draw_uno_and_stubs():
    ux0, uy0 = 40, BB_Y0 - 18
    uw = BB_X0 - ux0 - 70
    uh = (BB_Y1 - BB_Y0) + 36
    box(ux0, uy0, uw, uh, "#f8fafc")
    txt(ux0 + uw / 2.0, uy0 + 30, "Arduino Uno", 16, "middle", "700")
    txt(ux0 + uw / 2.0, uy0 + 52, "(ATmega328P 보드)", 12, "middle", "400", MUTE)
    txt(ux0 + uw / 2.0, uy0 + uh - 16, "USB 케이블로 PC 연결 (전원 + UART 로그)",
        10.5, "middle", "400", MUTE)

    pins = [
        ("GND", WIRE_GND, (x_of(0), Y_RAIL_T_MINUS)),
        ("5V", WIRE_VCC, (x_of(0), Y_RAIL_T_PLUS)),
        ("D2", WIRE_SIG, (x_of(SW_COLS[0][1]), ROWS_TOP["a"])),
        ("D3", WIRE_SIG, (x_of(SW_COLS[1][1]), ROWS_TOP["a"])),
        ("D4", WIRE_SIG, (x_of(SW_COLS[2][1]), ROWS_TOP["a"])),
        ("D5", WIRE_SIG, (x_of(SW_COLS[3][1]), ROWS_TOP["a"])),
        ("D7 (AIN1)", WIRE_SIG, (x_of(MCU_TAP_COL), ROWS_TOP["a"])),
        ("A0 (ADC0)", WIRE_SIG, (x_of(MCU_TAP_COL), ROWS_TOP["b"])),
        ("A5 (SCK)", WIRE_I2C, (x_of(OLED_COLS[2]), ROWS_BOT["j"])),
        ("A4 (SDA)", WIRE_I2C, (x_of(OLED_COLS[3]), ROWS_BOT["j"])),
        ("D9 (PB1)", WIRE_ACT, (x_of(ACT_IN_COL), ROWS_TOP["a"])),
    ]
    n = len(pins)
    top, bot = uy0 + 74, uy0 + uh - 34
    for i, (label, color, (tx, ty)) in enumerate(pins):
        sy = top + i * ((bot - top) / float(n - 1))
        wire([(ux0 + uw, sy), (tx, sy), (tx, ty)], color, 2)
        dot(ux0 + uw, sy, color)
        txt(ux0 + uw - 10, sy - 6, label, 10.5, "end", "600", color)


# ---------------------------- 조립 ----------------------------

add('<svg xmlns="http://www.w3.org/2000/svg" viewBox="0 0 %d %d" '
    'width="%d" height="%d" font-family="%s">' % (W, H, W, H, FONT))
add('<rect width="%d" height="%d" fill="#ffffff"/>' % (W, H))
box(14, 14, W - 28, H - 28, "none", INK, 2)
txt(W / 2.0, 40, "knock2fa 브링업 ⑥ — 액추에이터 / 상태 LED 추가 (회로 최종 완성)",
    17, "middle", "700")
txt(W / 2.0, 60,
    "②③④단계는 그대로 두고 D9(PB1)에 R2(330Ω)·D1(LED)만 새로 추가한다. "
    "LED 로 먼저 확인 후 서보로 교체할 것.", 12, "middle", "400", MUTE)

draw_board()
draw_rail_bridges()
draw_switches()
draw_piezo()
draw_oled()
draw_actuator()
draw_uno_and_stubs()

# 범례
LX, LY = 40, H - 34
legend = [("GND", WIRE_GND), ("+5V", WIRE_VCC), ("디지털 신호 (D2~D5, D7, A0)", WIRE_SIG),
          ("I2C (SCK/SDA)", WIRE_I2C), ("액추에이터 (D9)", WIRE_ACT)]
lx = LX
for name, c in legend:
    line(lx, LY, lx + 26, LY, 3, c)
    txt(lx + 32, LY + 4, name, 11.5, "start", "600", c)
    lx += 190

add('</svg>')

root = os.path.dirname(os.path.dirname(os.path.abspath(__file__)))
outdir = os.path.join(root, "figures")
if not os.path.isdir(outdir):
    os.makedirs(outdir)
path = os.path.join(outdir, "breadboard_actuator.svg")
doc = "\n".join(out)
ET.fromstring(doc)
io.open(path, "w", encoding="utf-8").write(doc)
print("생성 완료: %s (%d bytes, XML 검증 통과)" % (path, os.path.getsize(path)))
