jms1005/knock2fa/(commit log)

2026-09-11 feat: knock2fa 예선 제출용 프로젝트 초기 커밋
    버튼 시퀀스 + 노크 리듬 이중인증 잠금 시스템 펌웨어, 도면, 제출물 초안 포함
    Claude-Session: https://claude.ai/code/session_01713bmUQJo7uNjxqW6vhqSy
2026-09-11 feat: 브링업 ⑥단계(액추에이터/상태 LED) 브레드보드 도면 추가
    D9(PB1) -> R2(330Ω) -> D1(LED) -> GND 배선을 ②③④단계 회로 위에 그려
    브링업 6단계 전체가 도면으로 커버되도록 했다.
    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
2026-09-12 fix: 브링업 실측 기반 불응기(BLANK_TICKS) 250ms로 확정
    실물 피에조로 노크 감지 테스트 중, 불응기를 50/100/200/400ms로
    바꿔가며 실측한 결과 값에 상관없이 그 값과 거의 같은 간격에서
    잔향이 다시 잡히는 현상을 확인. 브레드보드(무른 판) 위 장착이
    저주파 흔들림을 더했고, 책상 등 단단한 면 고정 + 댐핑으로 개선됨.
    - BLANK_TICKS 50ms -> 250ms, 실측 근거 주석 추가
    - README §3.2: 피에조 고정면(단단한 곳) 경고 추가
    - README §8: 브링업 ①~④단계 실물 검증 결과 반영
    (보드 업로드, 버튼/OLED, 비교기 에지 방향, 진폭 게이트 확인됨;
    불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
    [knock.c]
2026-09-18 chore: 제출용 체크리스트 및 캐시 파일 정리
    제출물 폴더에서 오래된 제출_체크리스트.md 제거, tools/__pycache__ 캐시와
    빈 디렉토리(docs/, .claude/) 삭제
2026-09-18 fix: 블록도·흐름도의 불응기·EEPROM 용량 표기를 실제 값에 맞춤
    BLANK_TICKS 250ms 확정(33370df)과 authstore.h 의 EEPROM 44바이트 배치를
    fig1_block.svg / fig2_flow.svg 라벨에 반영(기존 50ms/40B·38B 표기는 낡은 값)
    [make_figures.py]
2026-09-18 feat: 회로도 표제란에 팀명(노크온) 반영, 제출용 소스코드 재동기화
    - make_schematic.py 표제란의 "(팀명 기입)" 플레이스홀더를 "노크온"으로 확정
    - 위 변경을 반영해 schematic.svg/schematic_bringup.svg 및 PNG 미리보기 재생성
    - 제출물/소스코드.zip 을 최신 firmware(BLANK_TICKS 250ms 등) 기준으로 재생성
    (기존 다_소스코드.zip 은 250ms 확정 이전 스냅샷이었음)
    - 제출물 파일명에서 가/나/다 접두어 제거(나_회로도.pdf -> 회로도.pdf,
    다_소스코드.zip -> 소스코드.zip), 초안 가_예선보고서_초안.pptx 제거
2026-09-18 docs: 최종 보고서 및 대회 참고 문서 추가
    - 제출물/최종 보고서.pdf, .pptx (예선 제출용 발표 보고서)
    - 대회안내_공지사항.pdf, 대회운영_설명.pdf (대회 측 공지·운영 설명 원본)
    - 버튼시퀀스_노크리듬_2FA_계획서.docx (초기 기획서)
    - 루트의 최종 보고서.pdf (제출물 폴더 사본과 다른 버전이라 별도 보관)
